smallwins128/pen-plotter/hardware/web/reel/NOTES.md

# Reel notes

Moved on 2026-10-28. The reel method now lives in the `gtm-reel` skill in the copilot repo:
`.claude/skills/gtm-reel/`.

- `SKILL.md`: the steps
- `references/craft.md`: shots, camera and caption rules
- `scripts/render_reel.js`: a generic renderer
- `LEARNINGS.md`: lessons from each reel

This folder keeps the Harbor reel itself as the worked example: `harbor_reel.html`, and
`render_reel.js` hard-wired to it.
