smallwins128/pen-plotter/hardware/labels/labels.pdf

R05 HARBOR · GREY BINS | Print at 100% / actual size. Do not use fit to page.

M3 G01 COUNTERSUNK · FOR 3D PRINTS

CSK | M3 G02 BUTTON · PAN · SOCKET · FLANGE
OTHERS | M4 G03 SHORT LENGTHS

# SMALL

M4 G04 LONG LENGTHS

LARGE | M5 G05 ALL HEADS · ALL LENGTHS

# SCREWS

G06

# RIVETS · RIVNUTS

G07 PLAIN · NYLOC

# NUTS

G08 STANDOFFS

# WASHERS · SPACERS

G09

G10 | G11 | G12

M3 G01 COUNTERSUNK · FOR 3D PRINTS

CSK | M3 G02 BUTTON · PAN · SOCKET · FLANGE
OTHERS | M4 G03 SHORT LENGTHS

# SMALL

M4 G04 LONG LENGTHS

LARGE | M5 G05 ALL HEADS · ALL LENGTHS

# SCREWS

G06

# RIVETS · RIVNUTS

G07 PLAIN · NYLOC

# NUTS

G08 STANDOFFS

# WASHERS · SPACERS

G09

G10 | G11 | G12
Resistor colour code: | M2 red | M3 orange | M4 yellow | M5 green | M6 blue
Black with a shape: nuts, washers, rivets. Bottom edge is a mm scale from the colour block.

## this bar must measure 100 mm after printing

R05 HARBOR · SAMLA BOXES | Print at 100% / actual size. Do not use fit to page. ELECTRONICS
CODE | SIZE | HOME
S01 | 11 L

CONTENTS

# WIRE CARDS

SCAN

# ELECTRONICS

CODE | SIZE | HOME
S02 | 11 L

CONTENTS

# CONNECTORS

SCAN

# ELECTRONICS

CODE | SIZE | HOME
S03 | 11 L

CONTENTS

# HEAT-SHRINK

SCAN

# ELECTRONICS

CODE | SIZE | HOME
S04 | 5 L

CONTENTS

# JUMPERS

SCAN

# ELECTRONICS

CODE | SIZE | HOME
S05 | 5 L

CONTENTS

# WIRE OFFCUTS

SCAN

# ELECTRONICS

CODE | SIZE | HOME
S06 | 5 L

CONTENTS

# DUPONT

SCAN

# HARDWARE

CODE | SIZE | HOME
S07 | 11 L

CONTENTS

# ZIP TIES · ANCHORS

SCAN

# HARDWARE

CODE | SIZE | HOME
S08 | 11 L

CONTENTS

# EDGE GUARDS

SCAN

# PLUMBING

CODE | SIZE | HOME
S09 | 22 L

CONTENTS

# PLUMBING

SCAN

# MECHANICAL

CODE | SIZE | HOME
S10 | 22 L

CONTENTS

# OLD MOTORS

SCAN

R05 HARBOR · SAMLA BOXES | Print at 100% / actual size. Do not use fit to page. WOODWORKING
CODE | SIZE | HOME
S11
CONTENTS | SCAN

# SEWING

CODE | SIZE | HOME
S12
CONTENTS | SCAN

# ART SUPPLIES

CODE | SIZE | HOME
S13
CONTENTS | SCAN

# ELECTRICALS

CODE | SIZE | HOME
S14
CONTENTS | SCAN
CODE | SIZE | HOME
S15
CONTENTS | SCAN
CODE | SIZE | HOME
S16
CONTENTS | SCAN
