smallwins128/pen-plotter/hardware/labels/labels_plus7.pdf

M3

# CSK

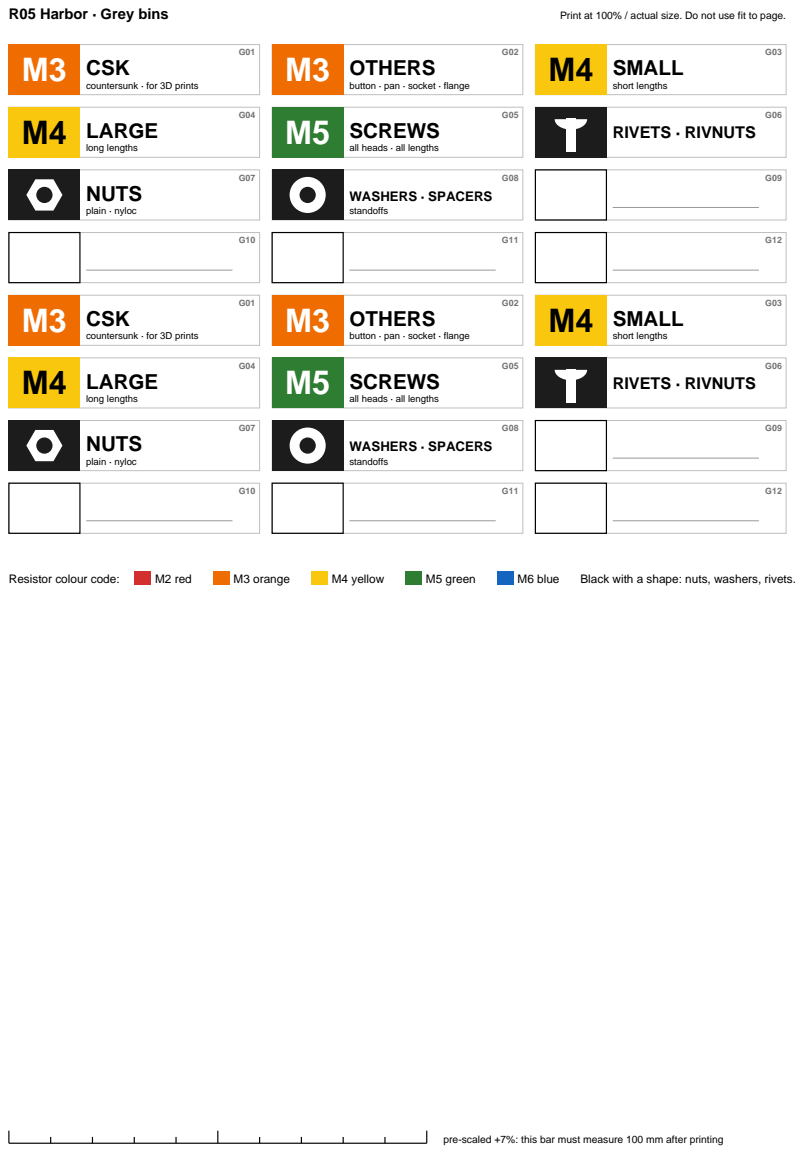
[picture p1: page 1]
R05 Harbor · Grey bins; Print at 100% / actual size. Do not use fit to page.; countersunk · for 3D prints; OTHERS; SMALL; short lengths; LARGE; long lengths; SCREWS; RIVETS · RIVNUTS; NUTS; plain · nyloc; WASHERS · SPACERS; standoffs; CSK; Resistor colour code:; M2 red; M3 orange; M4 yellow; M5 green; M6 blue; Black with a shape: nuts, washers, rivets.

button · pan · socket · flange

all heads · all lengths

countersunk · for 3D prints

pre-scaled +7%: this bar must measure 100 mm after printing

R05 Harbor · SAMLA boxes | Print at 100% / actual size. Do not use fit to page.
S01 | ELECTRONICS

# WIRE CARDS

11 L

HOME RB-1

S02 | ELECTRONICS

# CONNECTORS

11 L

HOME RB-1

S03 | ELECTRONICS

# HEAT-SHRINK

11 L

HOME RB-2

S04 | ELECTRONICS

# JUMPERS

5 L

HOME A3-C

S05 | ELECTRONICS

# WIRE OFFCUTS

5 L

HOME A3-C

S06 | ELECTRONICS

# DUPONT

5 L

HOME A3-C

S07 | HARDWARE

# ZIP TIES · ANCHORS

11 L

# HOME A3-UL

S08 | HARDWARE

# EDGE GUARDS

11 L

# HOME A3-UL

S09 | PLUMBING

# PLUMBING

22 L

# HOME A3-UR

S10 | MECHANICAL

# OLD MOTORS

22 L

# HOME A3-LL

R05 Harbor · SAMLA boxes | Print at 100% / actual size. Do not use fit to page.
S11 | WOODWORKING

HOME

S12 | SEWING

HOME

S13 | ART SUPPLIES

HOME

S14 | ELECTRICALS

HOME
S15

HOME

S16

HOME

R05 Harbor · Cupboard and rack spots | Print at 100% / actual size. Do not use fit to page.

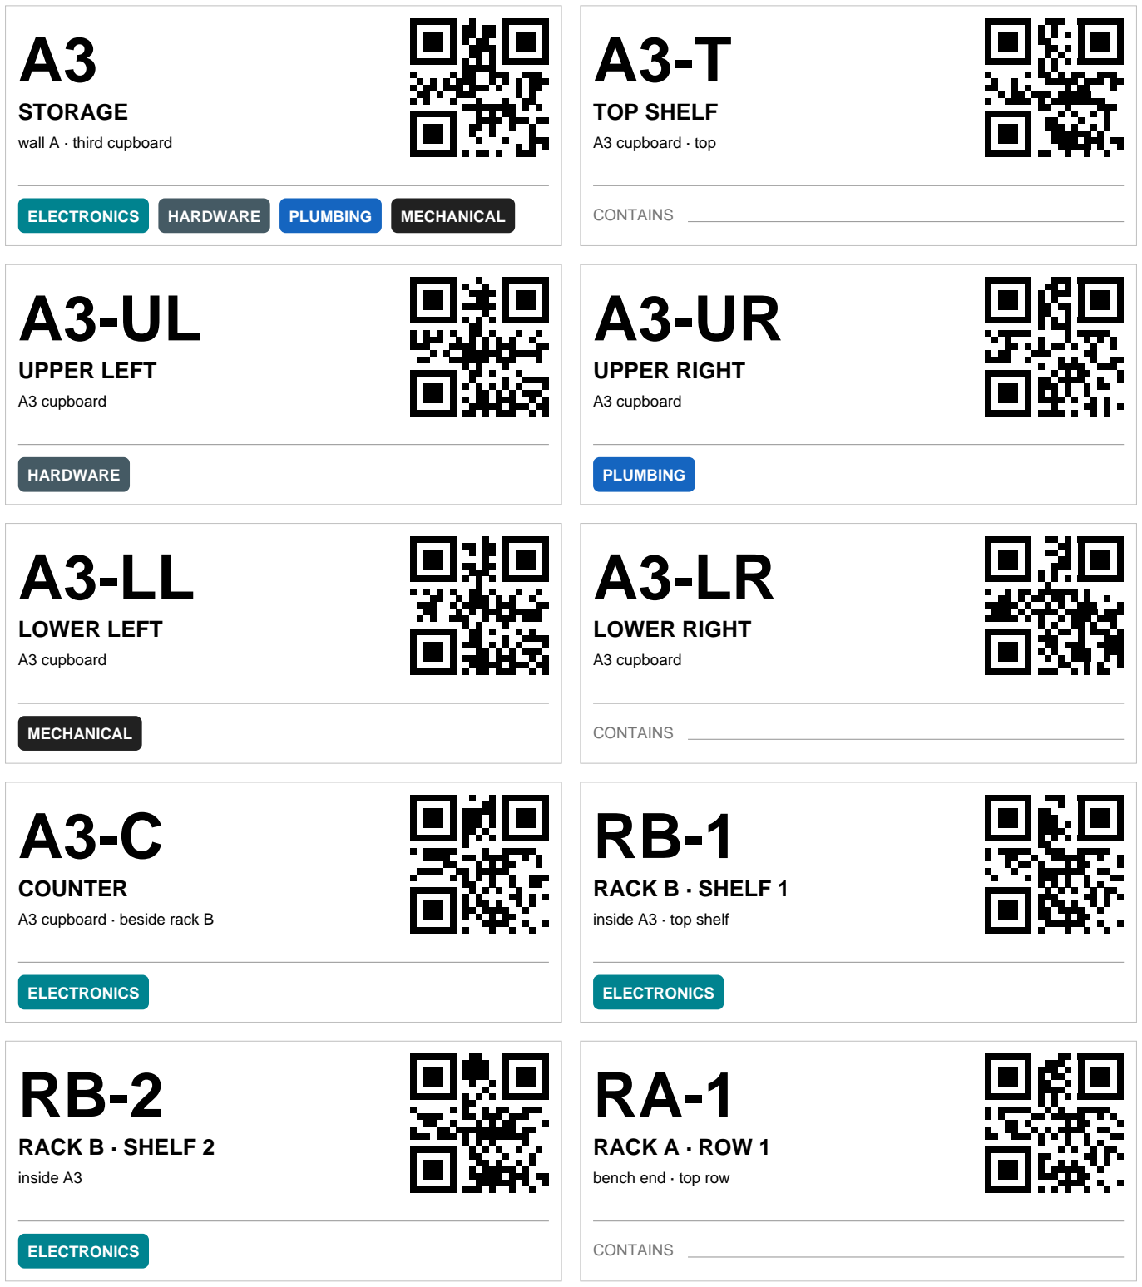
[picture p2: figure]
STORAGE; wall A · third cupboard; ELECTRONICS; HARDWARE; PLUMBING; MECHANICAL; TOP SHELF; A3 cupboard · top; CONTAINS; UPPER LEFT; A3 cupboard; UPPER RIGHT; LOWER LEFT; LOWER RIGHT; COUNTER; A3 cupboard · beside rack B; RACK B · SHELF 1; inside A3 · top shelf; RACK B · SHELF 2; inside A3; RACK A · ROW 1; bench end · top row

RA-2

## RACK A · ROW 2

bench end

CONTAINS

RA-3

## RACK A · ROW 3

bench end · bottom row

CONTAINS
