smallwins128/pen-plotter/hardware/out/din_mounts/preview.png

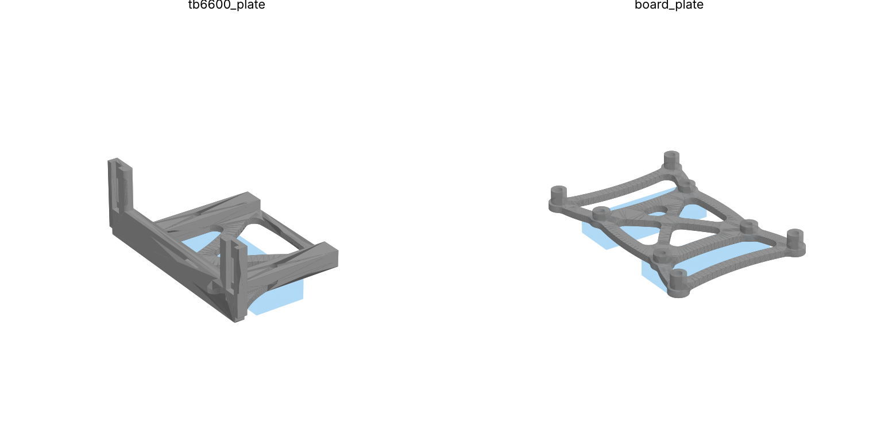
hardware/out/din_mounts/preview.png
