smallwins128/pen-plotter/hardware/out/layout/control_layout.png

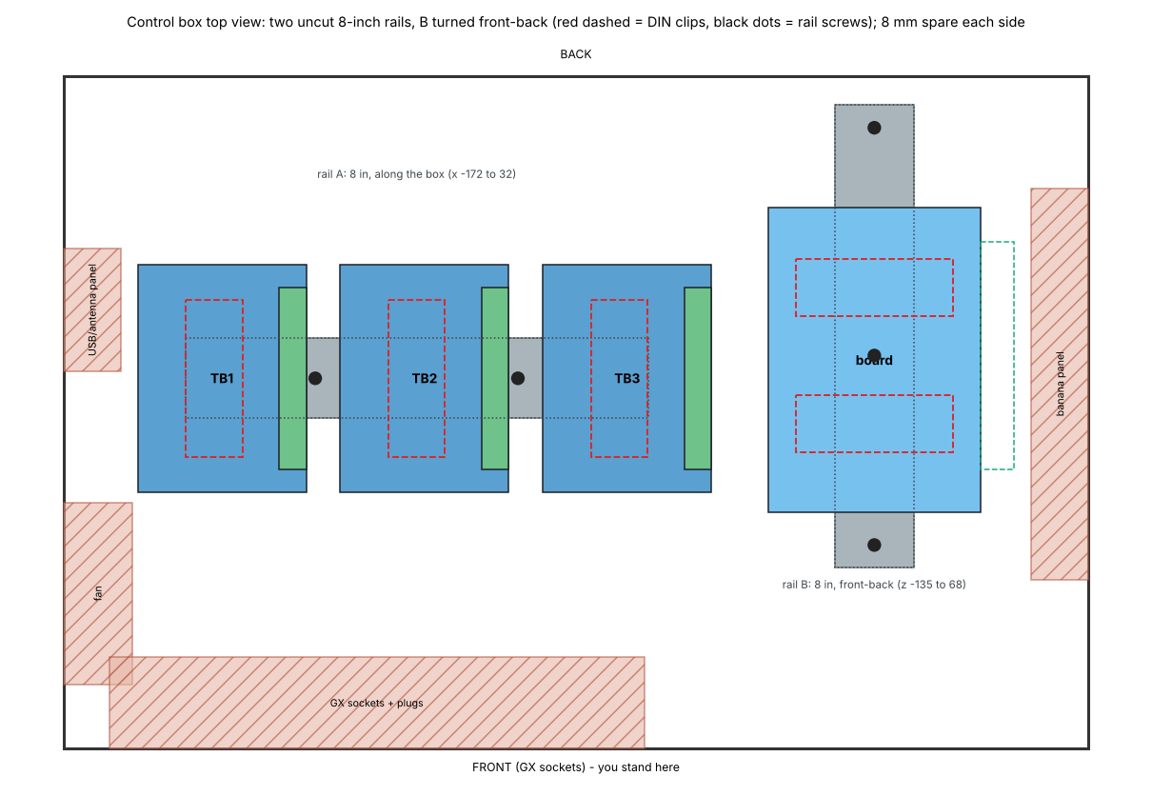
hardware/out/layout/control_layout.png
