smallwins128/pen-plotter/hardware/cutfiles/2026-10-15 Acrylic windows v1/ACRYLIC_WINDOWS.dxf

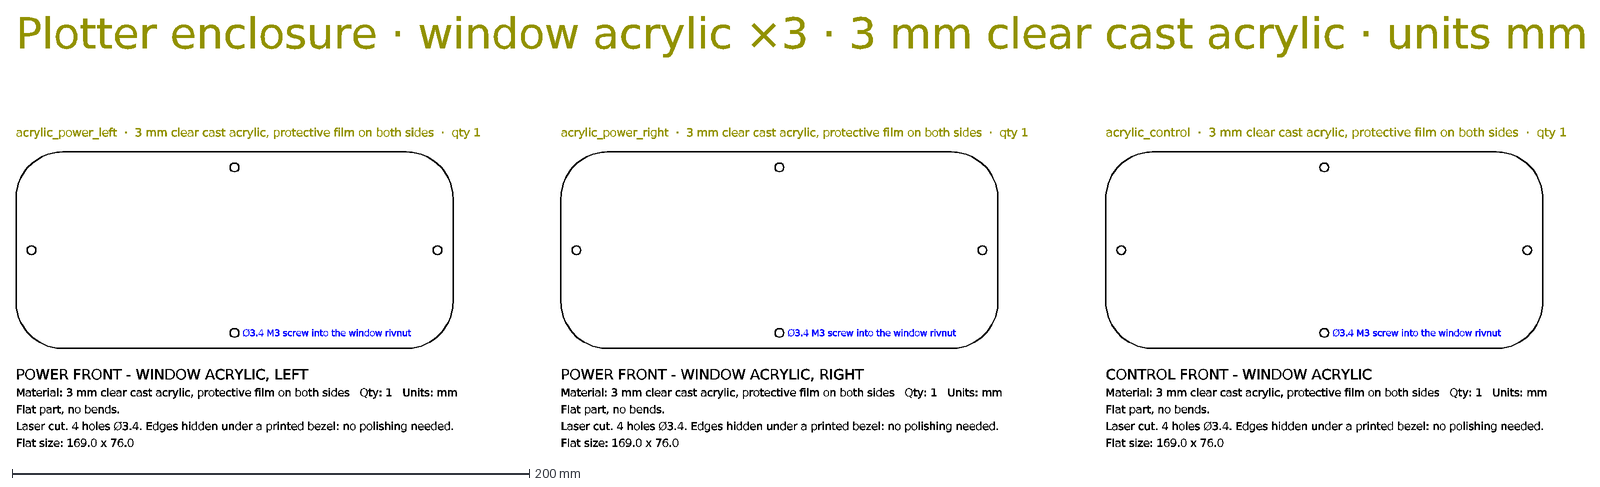
[picture p15: CAD file, 2026-10-15]
hardware/cutfiles/2026-10-15 Acrylic windows v1/ACRYLIC_WINDOWS.dxf
Ø3.4 M3 screw into the window rivnut
POWER FRONT - WINDOW ACRYLIC, LEFT
Material: 3 mm clear cast acrylic, protective film on both sides Qty: 1 Units: mm
Flat part, no bends.
Laser cut. 4 holes Ø3.4. Edges hidden under a printed bezel: no polishing needed.
Flat size: 169.0 x 76.0
acrylic_power_left · 3 mm clear cast acrylic, protective film on both sides · qty 1
POWER FRONT - WINDOW ACRYLIC, RIGHT
acrylic_power_right · 3 mm clear cast acrylic, protective film on both sides · qty 1
CONTROL FRONT - WINDOW ACRYLIC
acrylic_control · 3 mm clear cast acrylic, protective film on both sides · qty 1
Plotter enclosure · window acrylic ×3 · 3 mm clear cast acrylic · units mm
