smallwins128/pen-plotter/hardware/cutfiles/2026-10-16 v6/DXF 2004/control_lid.dxf

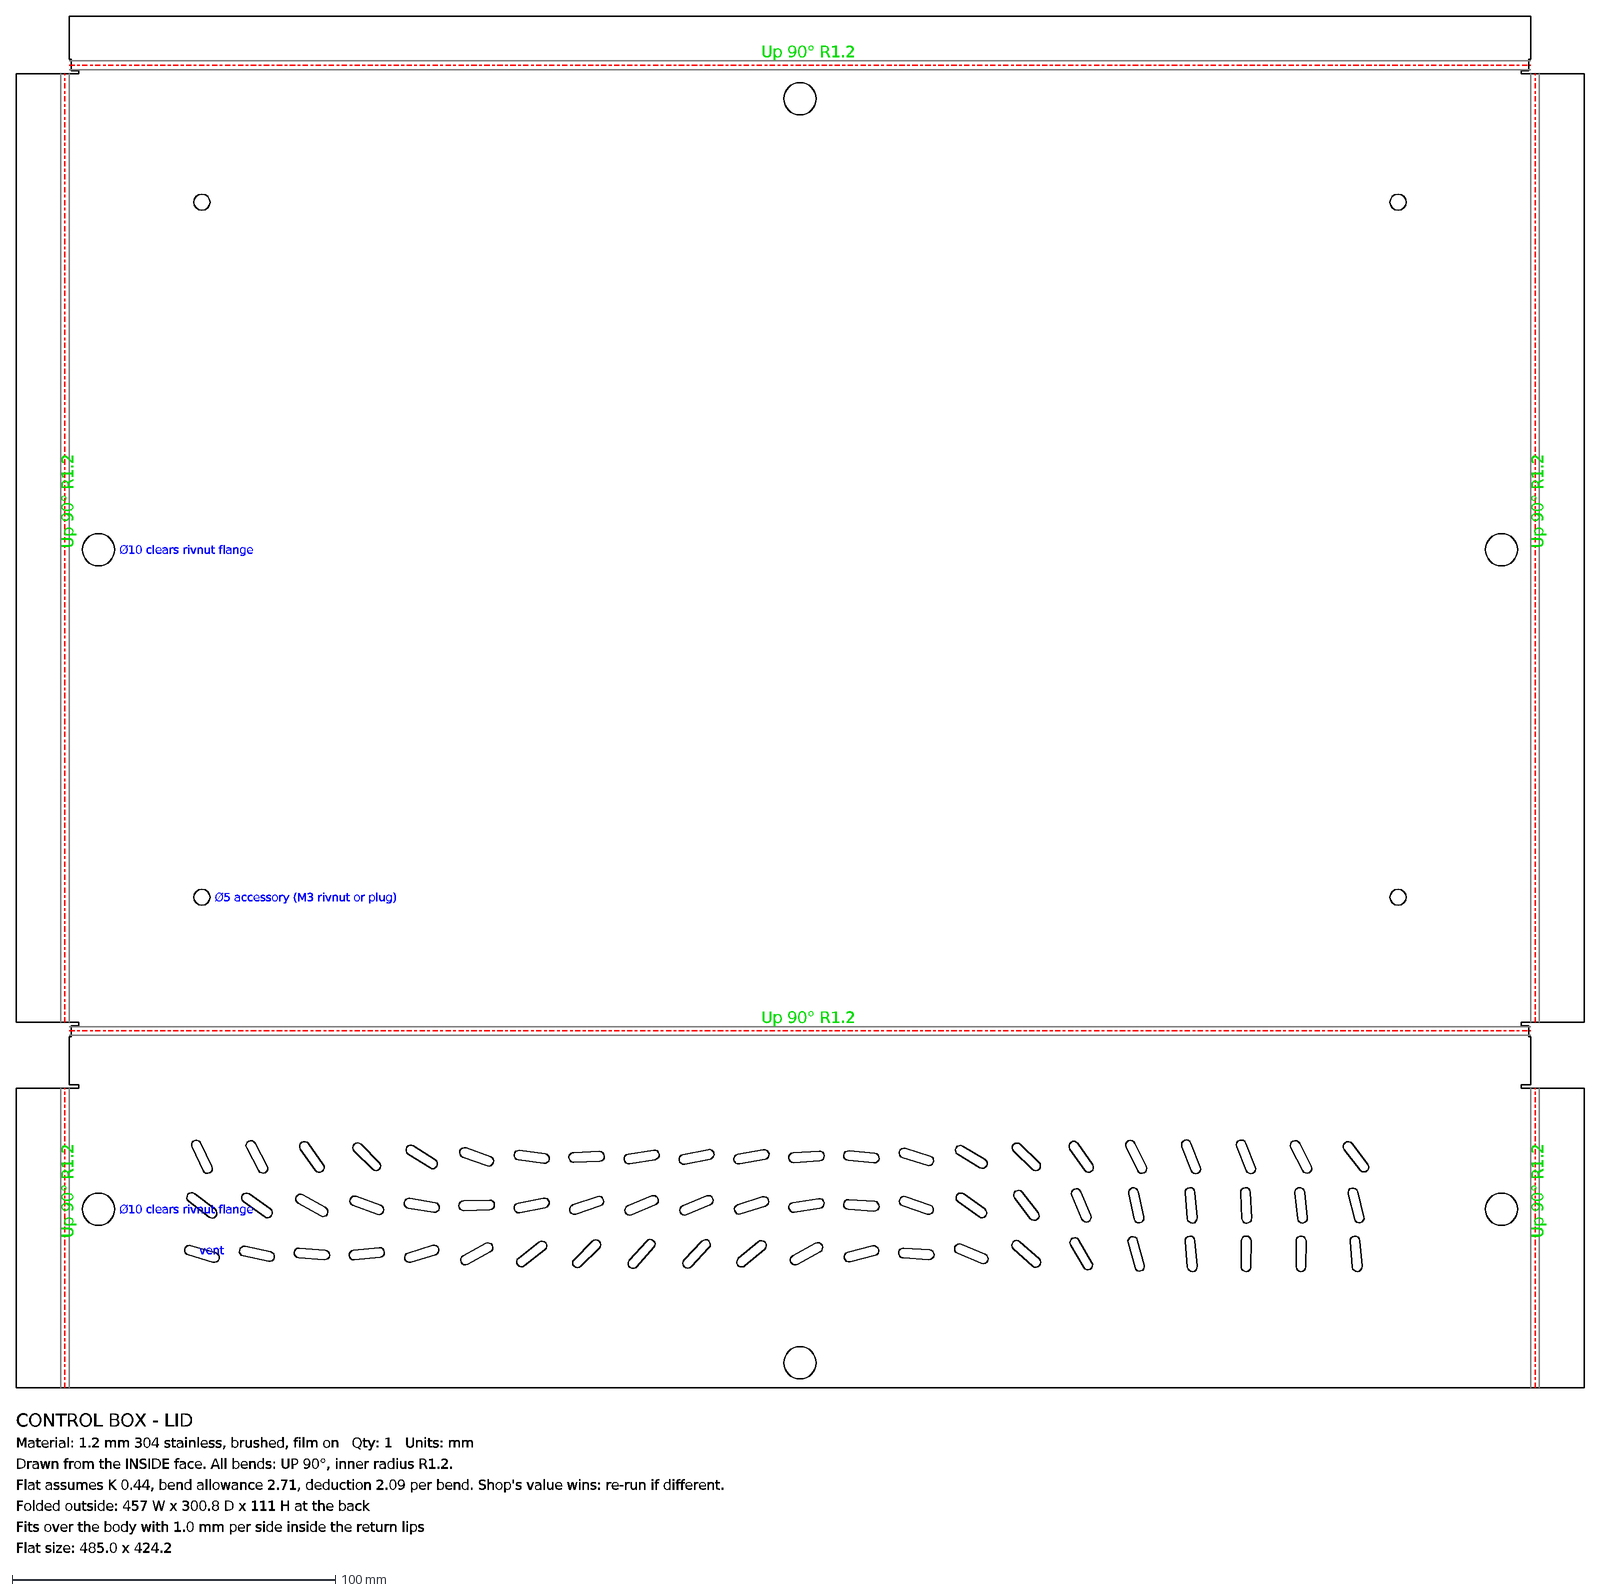
[picture p16: CAD file, 2026-10-29]
hardware/cutfiles/2026-10-16 v6/DXF 2004/control_lid.dxf
Up 90° R1.2
Ø10 clears rivnut flange
Ø5 accessory (M3 rivnut or plug)
vent
CONTROL BOX - LID
Material: 1.2 mm 304 stainless, brushed, film on Qty: 1 Units: mm
Drawn from the INSIDE face. All bends: UP 90°, inner radius R1.2.
Flat assumes K 0.44, bend allowance 2.71, deduction 2.09 per bend. Shop's value wins: re-run if different.
Folded outside: 457 W x 300.8 D x 111 H at the back
Fits over the body with 1.0 mm per side inside the return lips
Flat size: 485.0 x 424.2
