smallwins128/pen-plotter/hardware/out/bend_jig/bend_sleeve_d24.stl

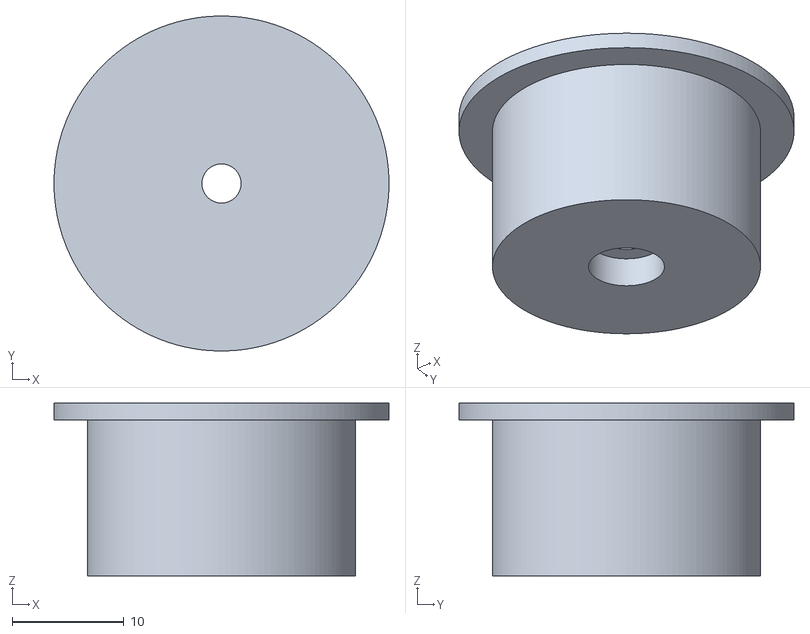
[picture p17: CAD file, 2026-10-29]
hardware/out/bend_jig/bend_sleeve_d24.stl
30.0 x 30.0 x 15.5
