smallwins128/pen-plotter/hardware/out/din_grip/din_grip_anchor_c0.3.stl

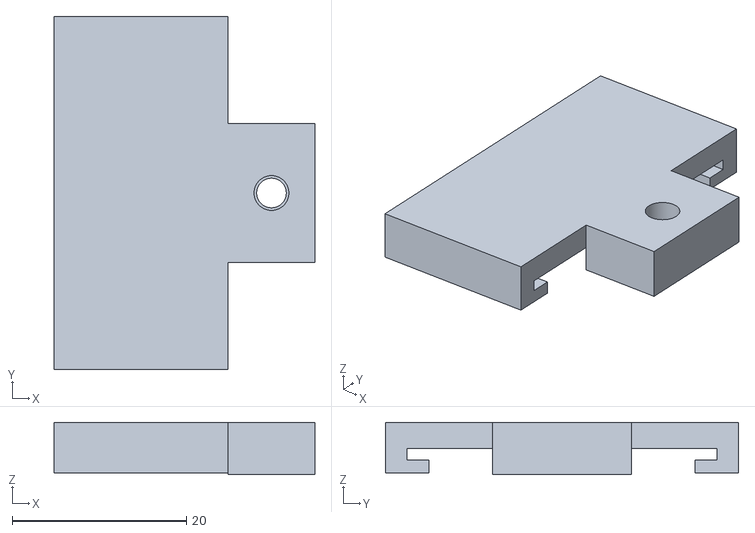
[picture p18: CAD file, 2026-10-29]
hardware/out/din_grip/din_grip_anchor_c0.3.stl
30.0 x 40.6 x 6.00
