smallwins128/pen-plotter/hardware/out/din_mounts/board_plate.stl

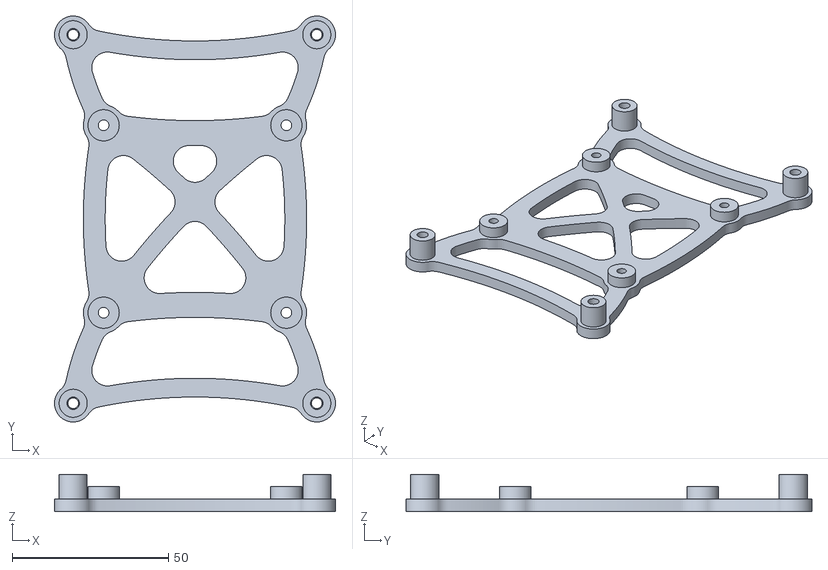
[picture p19: CAD file, 2026-10-29]
hardware/out/din_mounts/board_plate.stl
90.0 x 130.0 x 12.0
