smallwins128/pen-plotter/hardware/cutfiles/2026-10-14 v5/control_base_plate.dxf

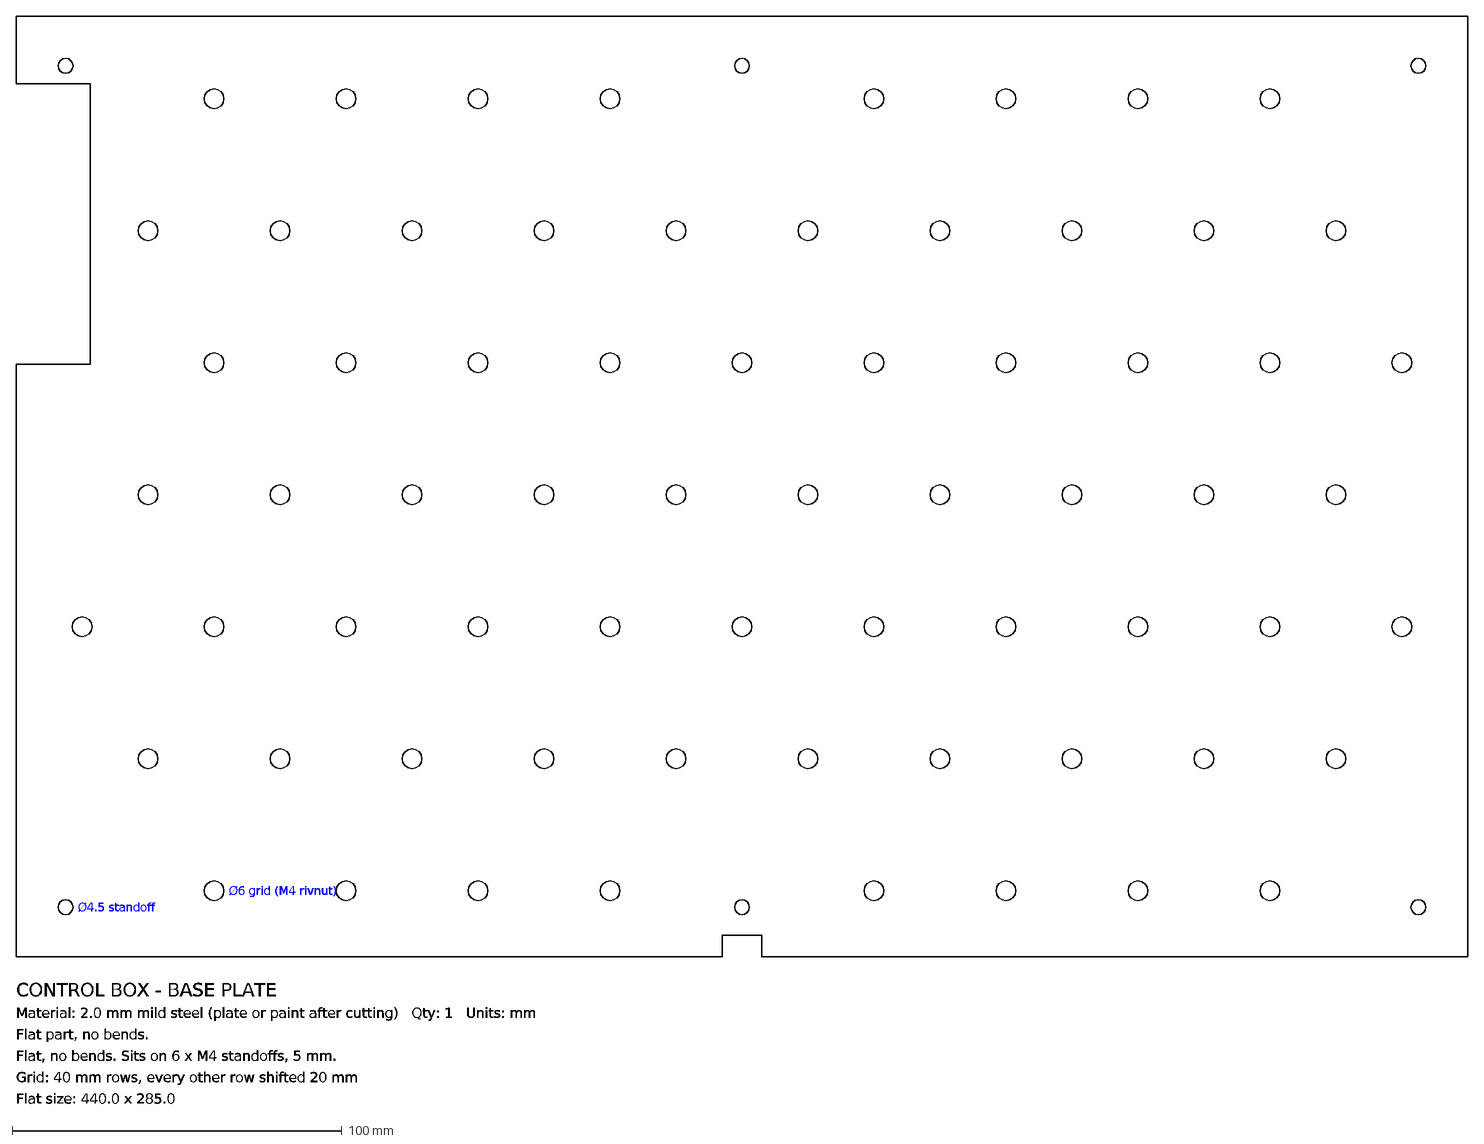
[picture p20: CAD file, 2026-10-14]
hardware/cutfiles/2026-10-14 v5/control_base_plate.dxf
Ø4.5 standoff
Ø6 grid (M4 rivnut)
CONTROL BOX - BASE PLATE
Material: 2.0 mm mild steel (plate or paint after cutting) Qty: 1 Units: mm
Flat part, no bends.
Flat, no bends. Sits on 6 x M4 standoffs, 5 mm.
Grid: 40 mm rows, every other row shifted 20 mm
Flat size: 440.0 x 285.0
