smallwins128/pen-plotter/hardware/out/din_grip/din_grip_coupon_c0.3.stl

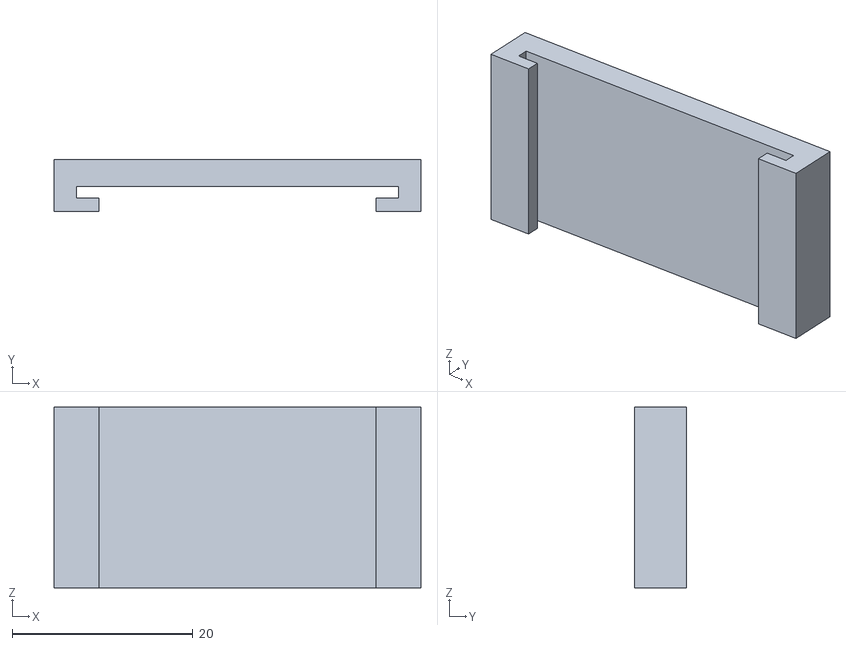
[picture p23: CAD file, 2026-10-29]
hardware/out/din_grip/din_grip_coupon_c0.3.stl
40.6 x 5.80 x 20.0
