smallwins128/pen-plotter/hardware/out/din_mounts/tb6600_plate.stl

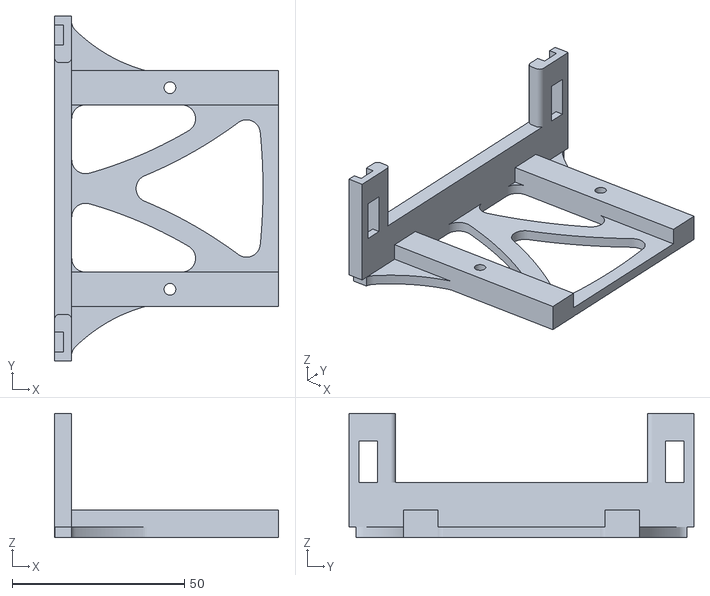
[picture p24: CAD file, 2026-10-29]
hardware/out/din_mounts/tb6600_plate.stl
65.0 x 100.0 x 36.0
