smallwins128/pen-plotter/hardware/cutfiles/2026-10-14 v5/power_lid.dxf

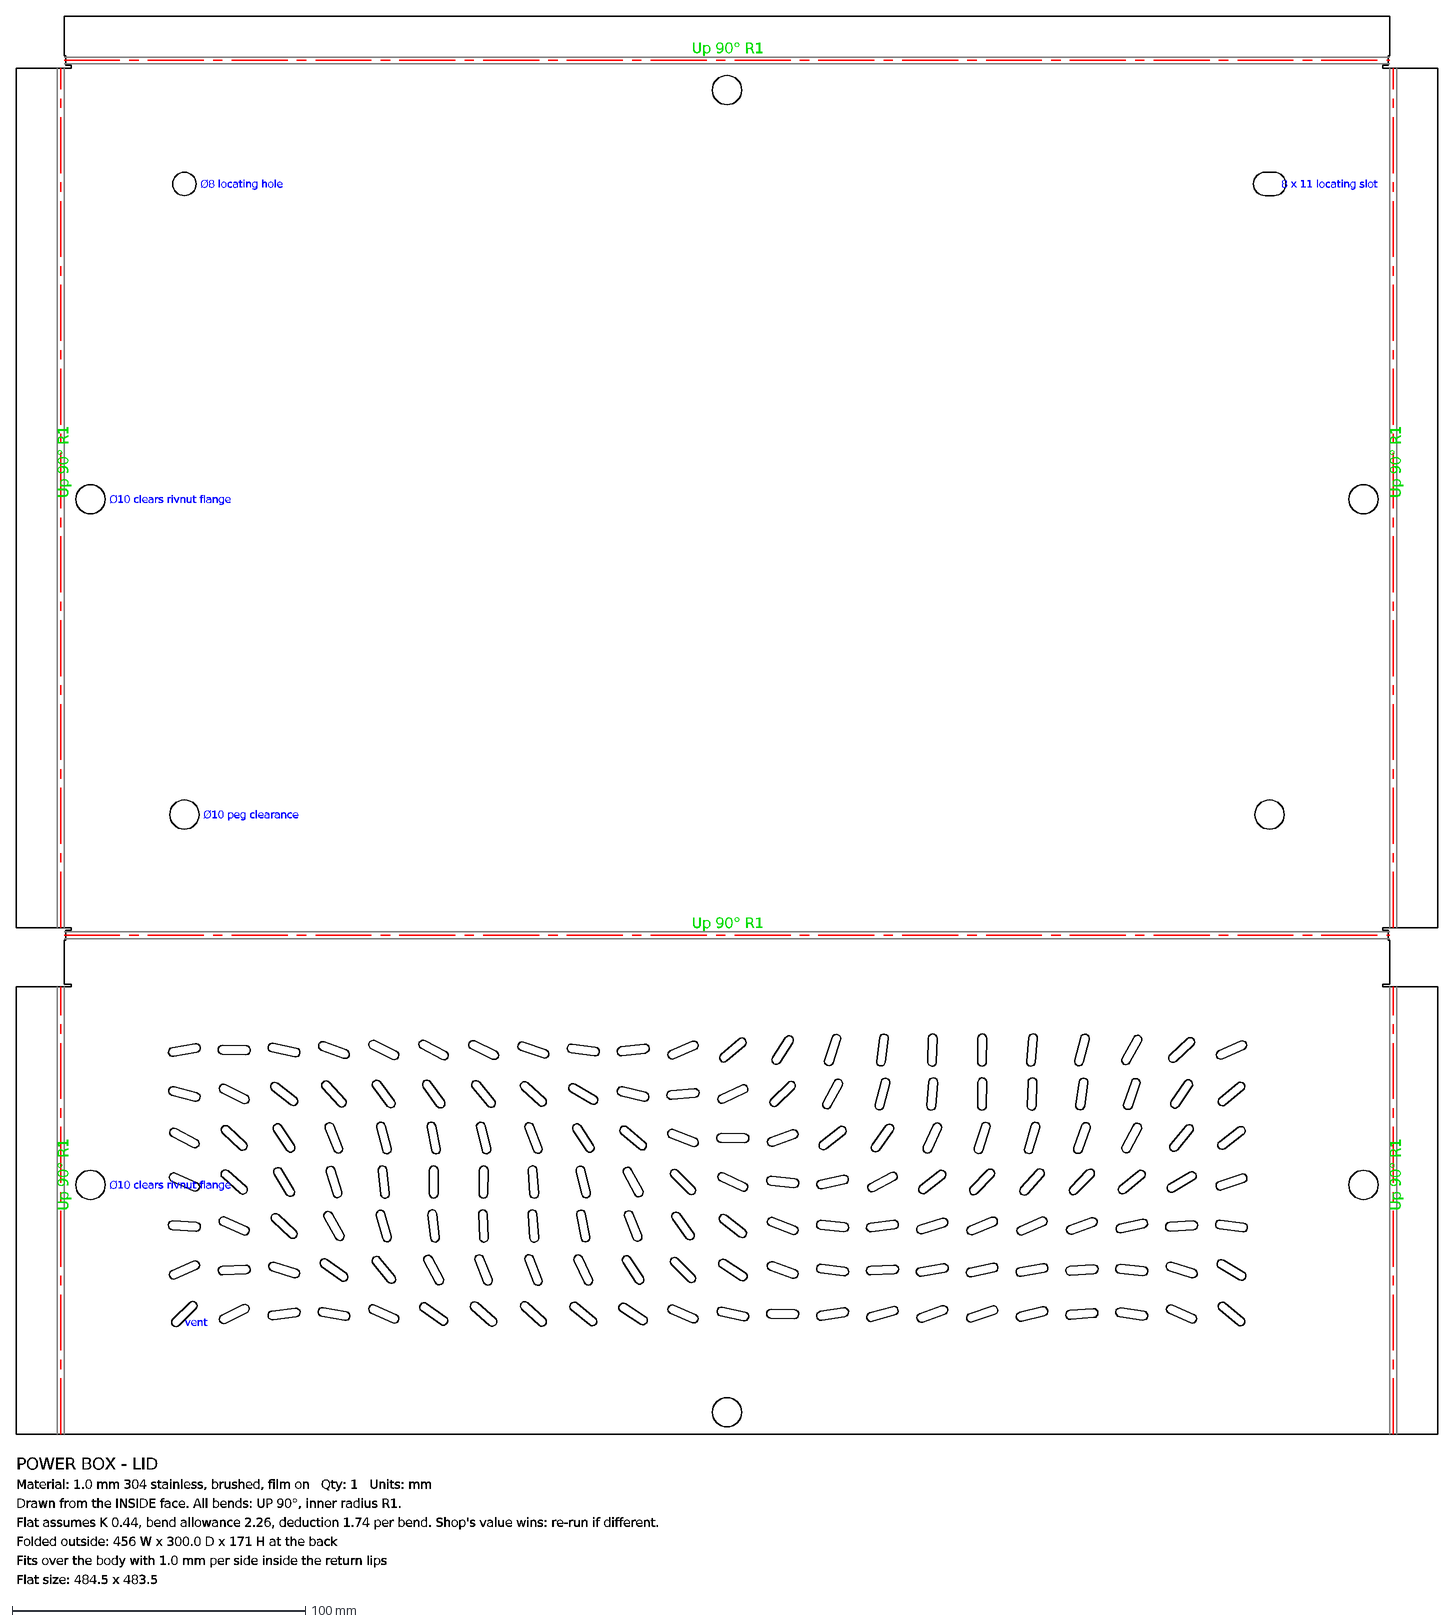
[picture p32: CAD file, 2026-10-14]
hardware/cutfiles/2026-10-14 v5/power_lid.dxf
Up 90° R1
Ø10 clears rivnut flange
Ø8 locating hole
8 x 11 locating slot
Ø10 peg clearance
vent
POWER BOX - LID
Material: 1.0 mm 304 stainless, brushed, film on Qty: 1 Units: mm
Drawn from the INSIDE face. All bends: UP 90°, inner radius R1.
Flat assumes K 0.44, bend allowance 2.26, deduction 1.74 per bend. Shop's value wins: re-run if different.
Folded outside: 456 W x 300.0 D x 171 H at the back
Fits over the body with 1.0 mm per side inside the return lips
Flat size: 484.5 x 483.5
