smallwins128/pen-plotter/hardware/cutfiles/2026-10-14 v5/acrylic_power_left.dxf

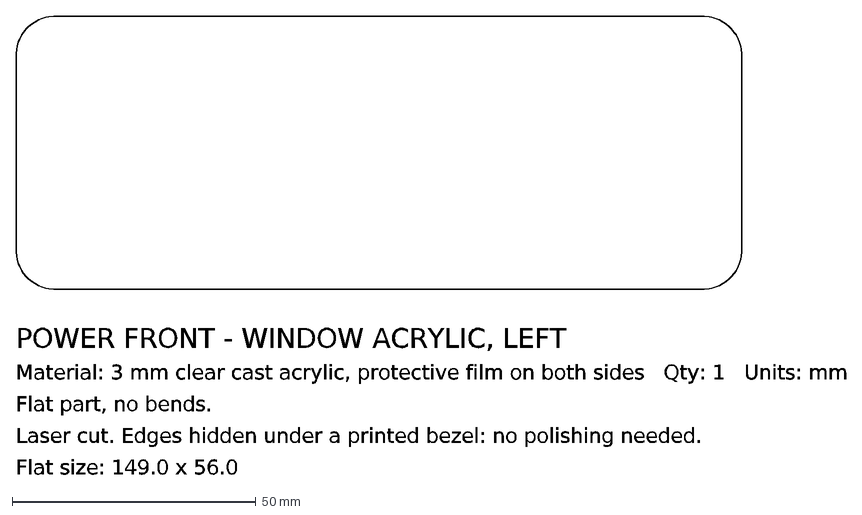
[picture p35: CAD file, 2026-10-14]
hardware/cutfiles/2026-10-14 v5/acrylic_power_left.dxf
POWER FRONT - WINDOW ACRYLIC, LEFT
Material: 3 mm clear cast acrylic, protective film on both sides Qty: 1 Units: mm
Flat part, no bends.
Laser cut. Edges hidden under a printed bezel: no polishing needed.
Flat size: 149.0 x 56.0
