smallwins128/pen-plotter/(list of files, cad)

Other CAD files:
hardware/cutfiles/2026-10-14 v5/ALL_MS.dxf
hardware/cutfiles/2026-10-14 v5/DXF 2004/ALL_ACRYLIC.dxf
hardware/cutfiles/2026-10-16 v6/power_body.dxf
hardware/cutfiles/2026-10-16 v6/DXF 2004/control_body.dxf
hardware/cutfiles/2026-10-14 v5/ALL_PARTS.dxf
hardware/cutfiles/2026-10-14 v5/power_base_plate.dxf
hardware/cutfiles/2026-10-14 v5/ALL_SS304.dxf
hardware/cutfiles/2026-10-14 v5/DXF 2004/control_body.dxf
hardware/cutfiles/2026-10-14 v5/ALL_ACRYLIC.dxf
hardware/cutfiles/2026-10-14 v5/ALL_STEEL_PARTS.dxf
hardware/cutfiles/2026-10-14 v5/DXF 2004/ALL_PARTS.dxf
hardware/cutfiles/2026-10-14 v5/ALL_ACRYLIC_PARTS.dxf
hardware/cutfiles/2026-10-14 v5/DXF 2004/control_base_plate.dxf
hardware/cutfiles/2026-10-14 v5/DXF 2004/ALL_MS.dxf
hardware/cutfiles/2026-10-14 v5/DXF 2004/power_body.dxf
hardware/cutfiles/2026-10-14 v5/power_body.dxf
hardware/cutfiles/2026-10-14 v5/DXF 2004/ALL_SS304.dxf
hardware/cutfiles/2026-10-14 v5/control_body.dxf
hardware/cutfiles/2026-10-11 v1/control_body.dxf
hardware/cutfiles/2026-10-11 v1/control_lid.dxf
hardware/cutfiles/2026-10-11 v1/power_body.dxf
hardware/cutfiles/2026-10-11 v1/power_lid.dxf
hardware/cutfiles/2026-10-11 v2/control_base_plate.dxf
hardware/cutfiles/2026-10-11 v2/control_body.dxf
hardware/cutfiles/2026-10-11 v2/power_base_plate.dxf
hardware/cutfiles/2026-10-11 v3/control_base_plate.dxf
hardware/cutfiles/2026-10-11 v3/power_base_plate.dxf
hardware/cutfiles/2026-10-11 v3/power_body.dxf
hardware/cutfiles/2026-10-11 v4/control_body.dxf
hardware/cutfiles/2026-10-11 v4/control_lid.dxf
hardware/cutfiles/2026-10-11 v4/power_body.dxf
hardware/cutfiles/2026-10-11 v4/power_lid.dxf
hardware/cutfiles/2026-10-12 v4/acrylic_control.dxf
hardware/cutfiles/2026-10-12 v4/acrylic_power_left.dxf
hardware/cutfiles/2026-10-12 v4/acrylic_power_right.dxf
hardware/cutfiles/2026-10-12 v4/control_base_plate.dxf
hardware/cutfiles/2026-10-12 v4/control_body.dxf
hardware/cutfiles/2026-10-12 v4/power_body.dxf
hardware/out/din_mounts/board_plate.dxf
hardware/out/din_mounts/tb6600_plate.dxf
