smallwins128/pen-plotter/hardware/cutfiles/2026-10-11 v4/2026-10-11 Plotter enclosure cut pack v4.pdf

# Plotter enclosures · cut & bend pack

Two stacked electronics boxes (control on top, power below), each a folded body + a folded lid, plus two flat base plates. Prepared by Allwin Tom · 2026-10-11 · v4

# | File | Part | Material | Qty | Flat (mm) | Bends | Folded outside (mm)

1 | control_body.dxf | CONTROL BOX · BODY | 1.0 mm 304 stainless, brushed, film on | 1 | 699.0 × 434.8 | 11 | 452 W × 297 D × 111 H
2 | control_lid.dxf | CONTROL BOX · LID | 1.0 mm 304 stainless, brushed, film on | 1 | 484.5 × 423.5 | 6 | 456 W × 300.0 D × 111 H (back)
3 | control_base_plate.dxf | CONTROL BOX · BASE PLATE | 2.0 mm aluminium 5052 (or 1.5 mm 304) | 1 | 440.0 × 285.0 | 0 | flat, 440 × 285, notched
4 | power_body.dxf | POWER BOX · BODY | 1.0 mm 304 stainless, brushed, film on | 1 | 819.0 × 494.8 | 11 | 452 W × 297 D × 171 H
5 | power_lid.dxf | POWER BOX · LID | 1.0 mm 304 stainless, brushed, film on | 1 | 484.5 × 483.5 | 6 | 456 W × 300.0 D × 171 H (back)
6 | power_base_plate.dxf | POWER BOX · BASE PLATE | 2.0 mm aluminium 5052 (or 1.5 mm 304) | 1 | 440.0 × 285.0 | 0 | flat, 440 × 285, notched

Bending

Every flat is drawn from the inside face. Every bend is UP 90°, inner radius R1.
Flats assume K 0.44, bend allowance 2.262 mm, bend deduction 1.738 mm per 90° bend (1 mm 304, R = t). If your bend deduction for 1 mm 304 at R1 differs, tell us the number: we re-issue the flats so every hole lands where it should.
Bend order: small lips first (top lips, back lips, corner tabs, base back lip), then the side walls, then the front wall last. Lid: return lips first, then the top-to-back bend.
Corner reliefs and end-of-flange reliefs are already cut into the outline.
Deliberate gaps, please keep: flange ends stop 2.5 mm short of neighbouring flanges; side-wall front edges and corner tabs stop 0.5 mm short of the front wall (the rivets close it); the lid is 1.0 mm per side larger than the body.

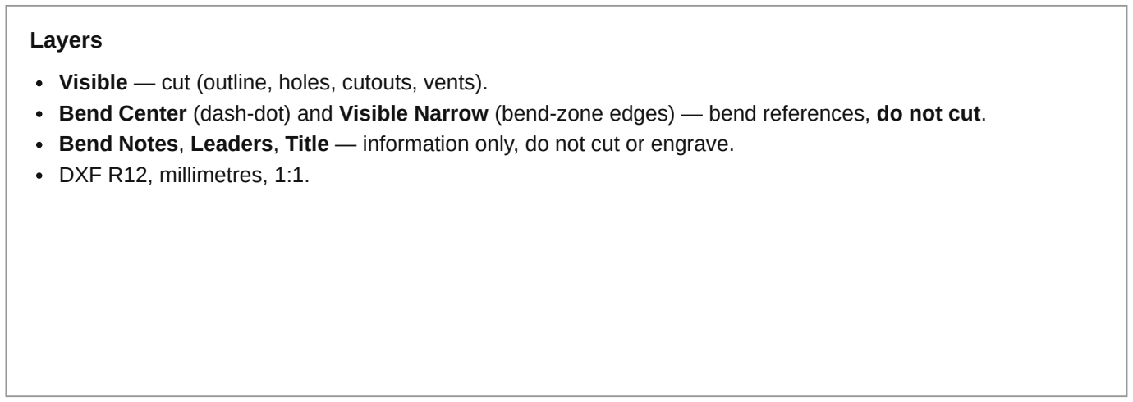
[picture p148: figure]
Layers; DXF R12, millimetres, 1:1.

Visible — cut (outline, holes, cutouts, vents).
Bend Center (dash-dot) and Visible Narrow (bend-zone edges) — bend references, do not cut. Bend Notes, Leaders, Title — information only, do not cut or engrave.

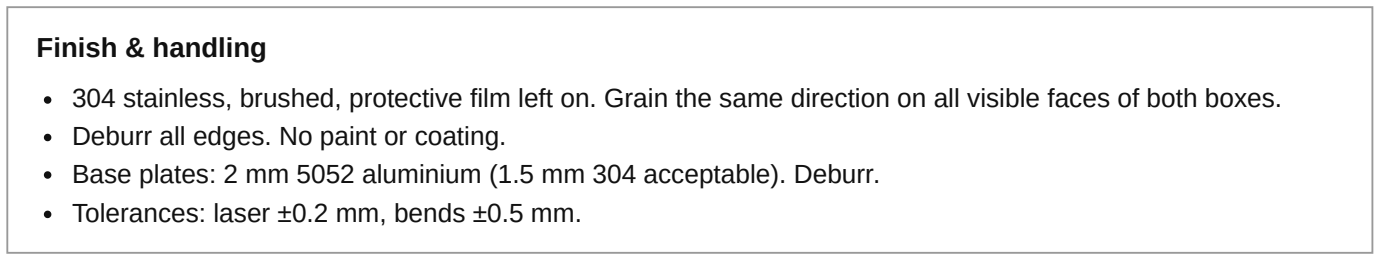
[picture p149: figure]
Finish & handling; Deburr all edges. No paint or coating.

304 stainless, brushed, protective film left on. Grain the same direction on all visible faces of both boxes.

Base plates: 2 mm 5052 aluminium (1.5 mm 304 acceptable). Deburr.
Tolerances: laser ±0.2 mm, bends ±0.5 mm.

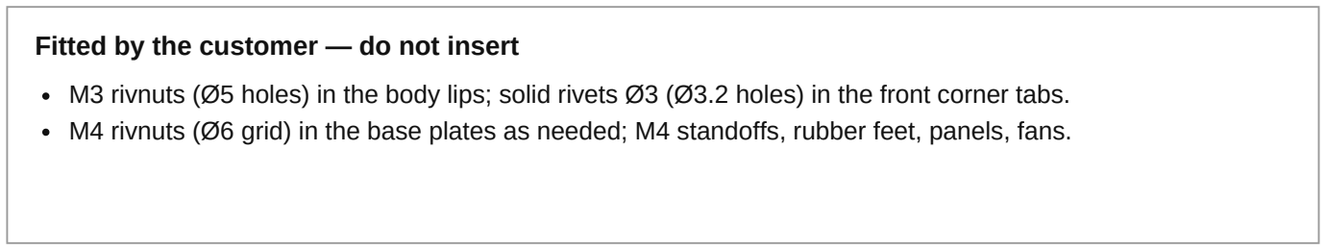
[picture p150: figure]
Fitted by the customer — do not insert

M3 rivnuts (Ø5 holes) in the body lips; solid rivets Ø3 (Ø3.2 holes) in the front corner tabs. M4 rivnuts (Ø6 grid) in the base plates as needed; M4 standoffs, rubber feet, panels, fans.

Checks: 723 design checks passed before these files were written — holes clear of bends (≥ 5 mm), webs ≥ 1.5 mm, folded parts free of clashes, folded flanges at least 2 mm apart wherever they are not meant to touch, whole assembly (fans, panels, rivnuts, base plate, standoffs) clear by 2 mm, lid clear of the body, every lid hole over its rivnut, base-plate standoffs over the floor's, panel cutouts and screw patterns matched to the printed panels. The files were then read back and re-folded from their own bend lines:

refold body width: 452.00 (design 452.00)
refold left wall height: 111.00 (design 111.00)
refold right wall height: 111.00 (design 111.00) refold body depth (base): 297.00 (design 297.00) refold front wall height: 111.00 (design 111.00) refold lid width: 456.00 (design 456.00)
refold lid depth: 300.00 (design 300.00)
refold body width: 452.00 (design 452.00) refold left wall height: 171.00 (design 171.00) refold right wall height: 171.00 (design 171.00)

refold body depth (base): 297.00 (design 297.00) refold front wall height: 171.00 (design 171.00) refold lid width: 456.00 (design 456.00)
refold lid depth: 300.00 (design 300.00)

### 1 · CONTROL BOX · BODY

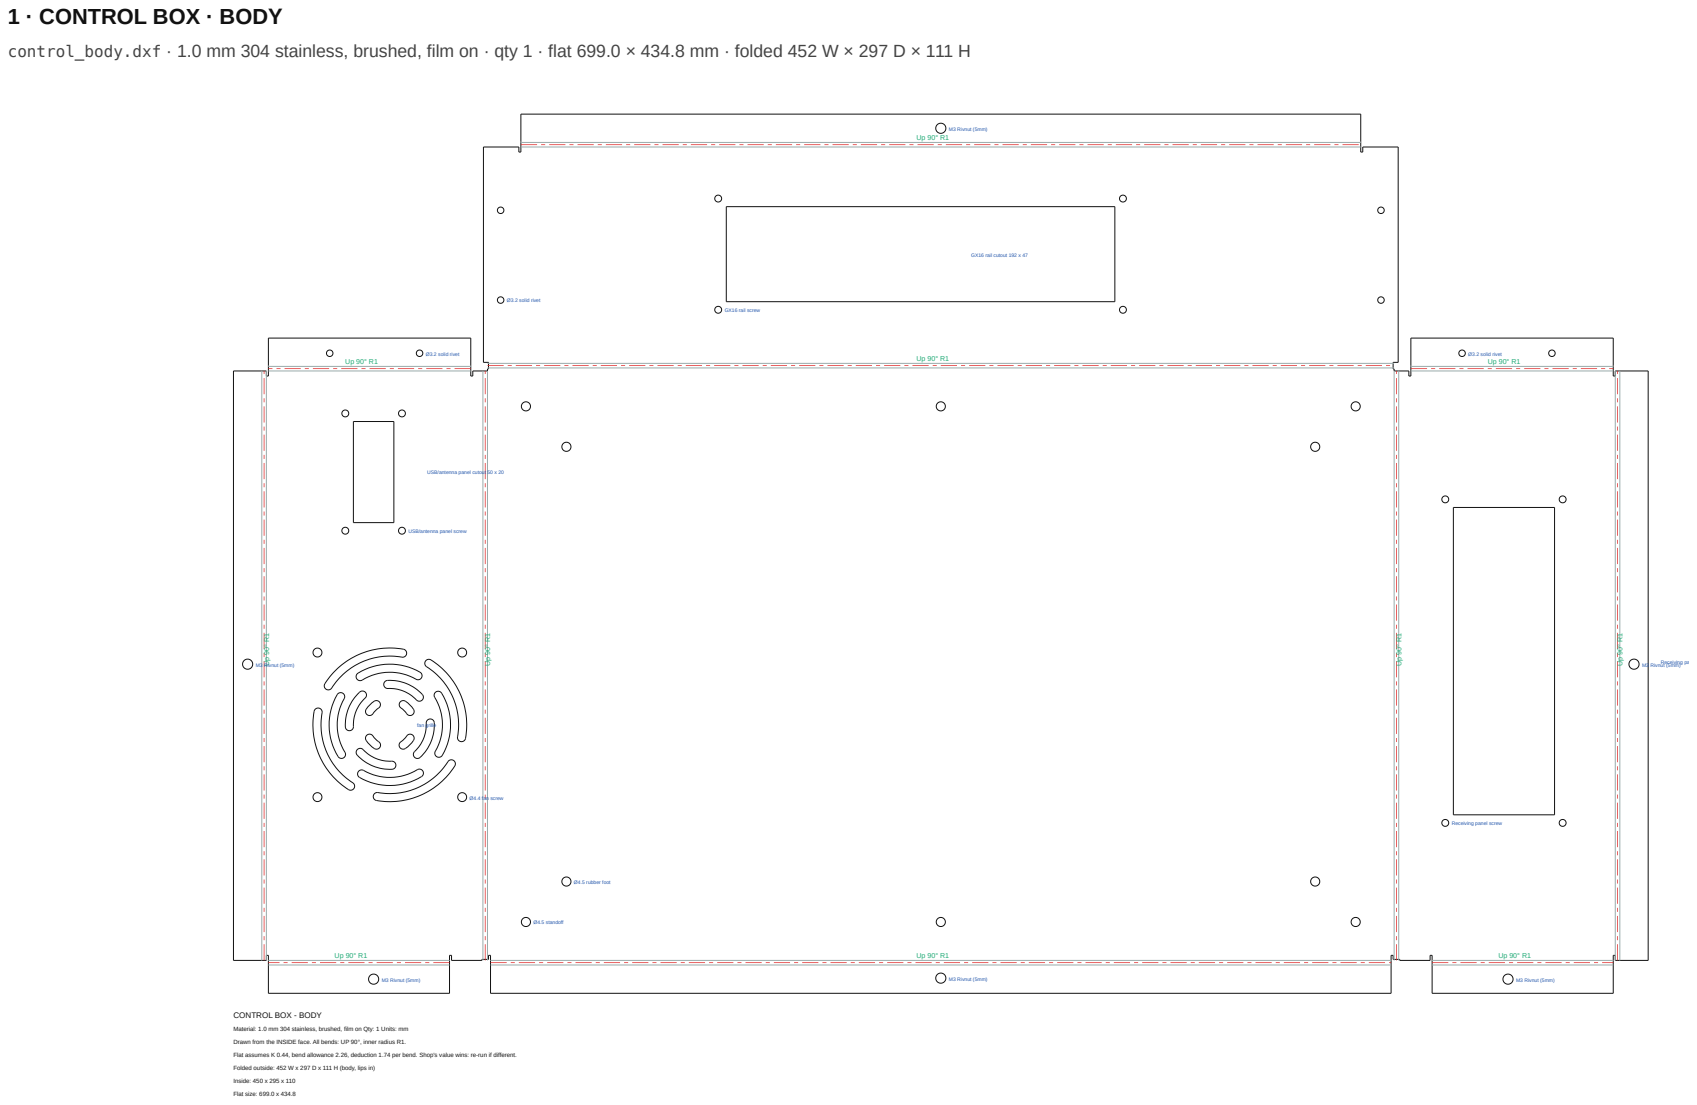
[picture p151: page 3]
Ø3.2 solid rivet; M3 Rivnut (5mm); Ø4.5 standoff; Ø4.5 rubber foot; GX16 rail cutout 192 x 47; GX16 rail screw; fan grille; Ø4.4 fan screw; Receiving pa; Inside: 450 x 295 x 110; Flat size: 699.0 x 434.8

control_body.dxf · 1.0 mm 304 stainless, brushed, film on · qty 1 · flat 699.0 × 434.8 mm · folded 452 W × 297 D × 111 H

USB/antenna panel cutout 50 x 20

USB/antenna panel screw

Receiving panel screw

CONTROL BOX - BODY

Material: 1.0 mm 304 stainless, brushed, film on Qty: 1 Units: mm

Drawn from the INSIDE face. All bends: UP 90°, inner radius R1.

Flat assumes K 0.44, bend allowance 2.26, deduction 1.74 per bend. Shop's value wins: re-run if different.

Folded outside: 452 W x 297 D x 111 H (body, lips in)

### 2 · CONTROL BOX · LID

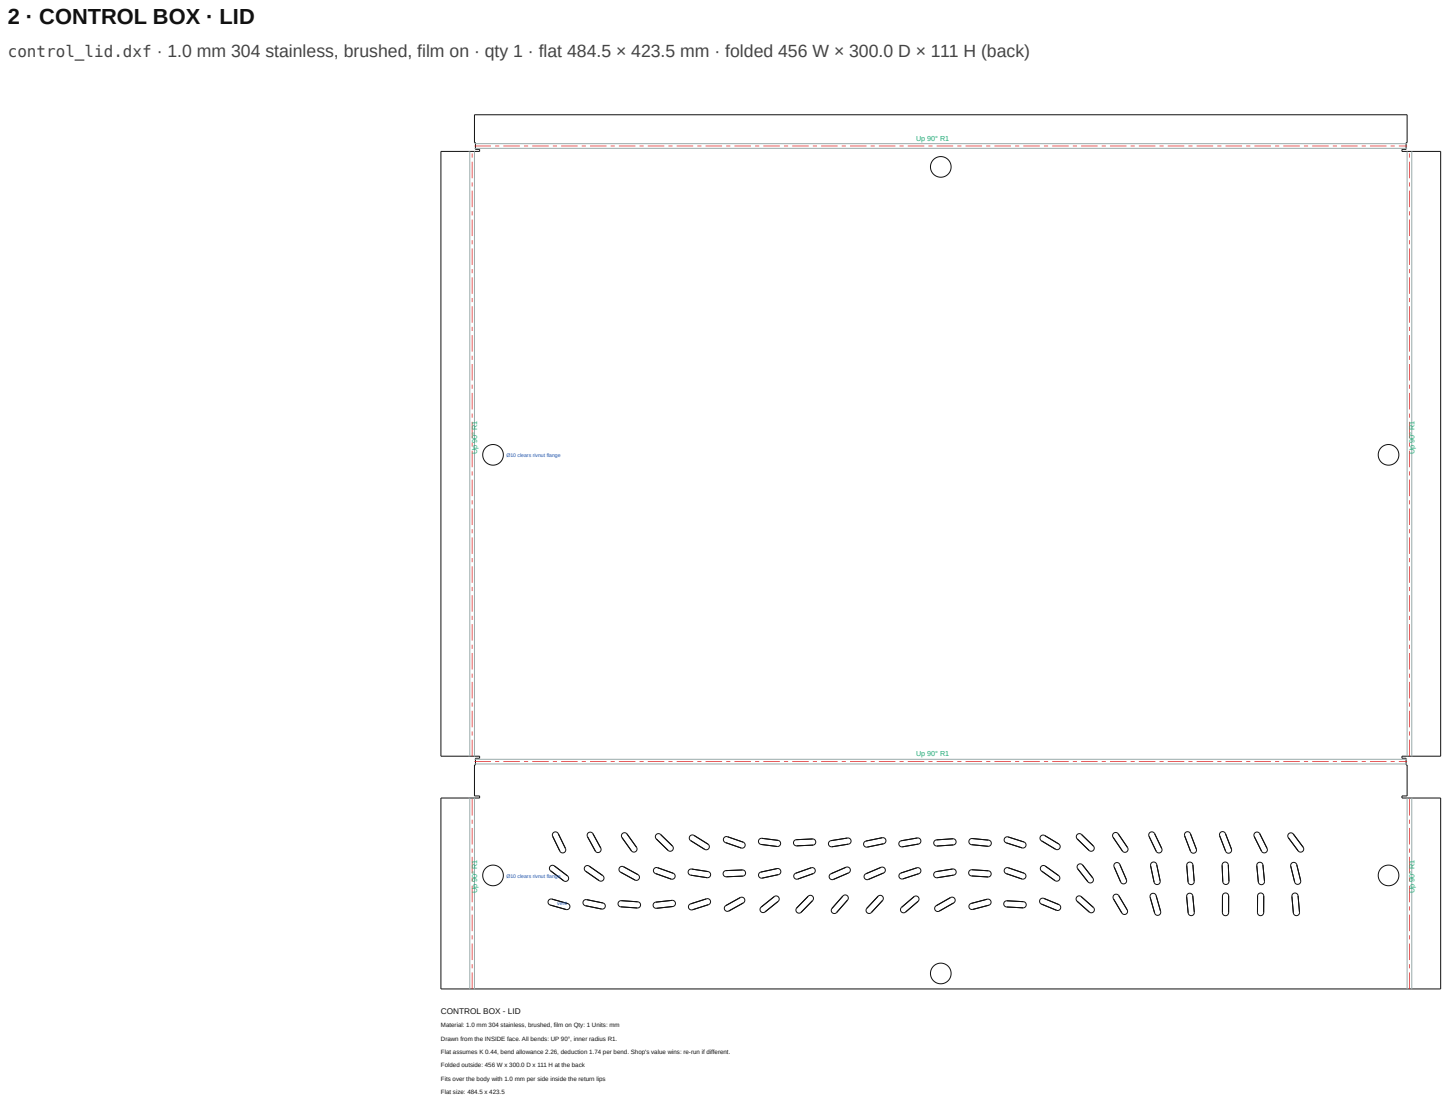
[picture p152: page 4]
vent; Flat size: 484.5 x 423.5

control_lid.dxf · 1.0 mm 304 stainless, brushed, film on · qty 1 · flat 484.5 × 423.5 mm · folded 456 W × 300.0 D × 111 H (back)

Ø10 clears rivnut flange

CONTROL BOX - LID

Material: 1.0 mm 304 stainless, brushed, film on Qty: 1 Units: mm

Drawn from the INSIDE face. All bends: UP 90°, inner radius R1.

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

Folded outside: 456 W x 300.0 D x 111 H at the back

Fits over the body with 1.0 mm per side inside the return lips

### 3 · CONTROL BOX · BASE PLATE

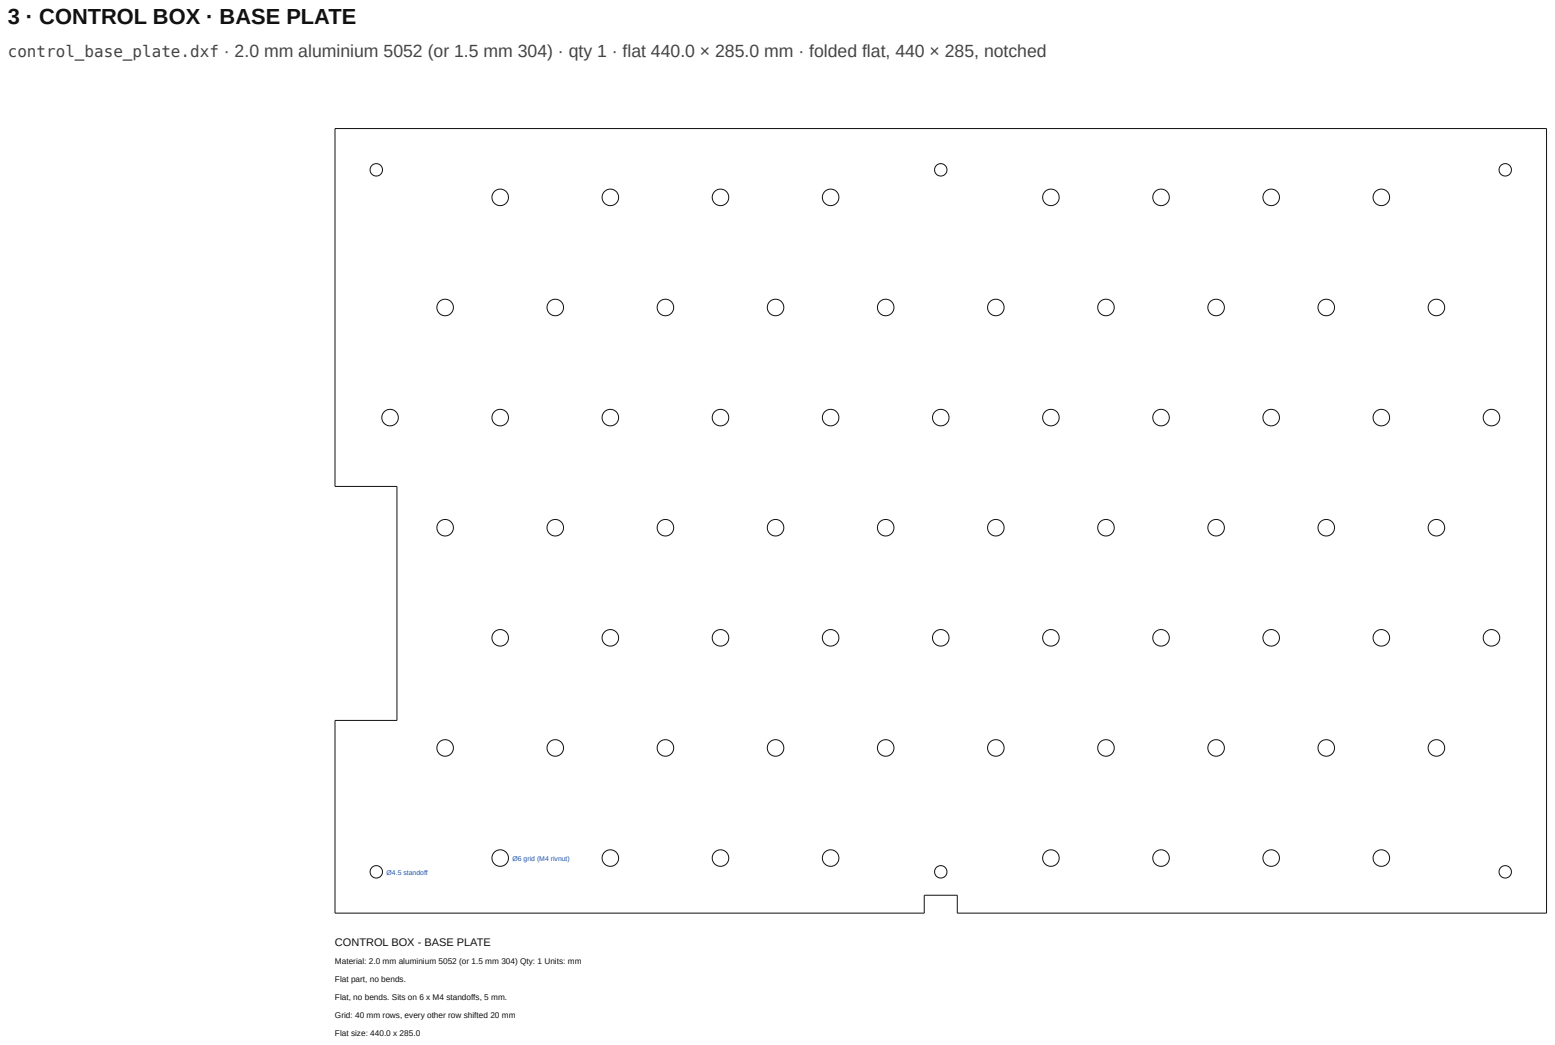
[picture p153: page 5]
Ø4.5 standoff; Ø6 grid (M4 rivnut); Flat size: 440.0 x 285.0

control_base_plate.dxf · 2.0 mm aluminium 5052 (or 1.5 mm 304) · qty 1 · flat 440.0 × 285.0 mm · folded flat, 440 × 285, notched

CONTROL BOX - BASE PLATE

Material: 2.0 mm aluminium 5052 (or 1.5 mm 304) Qty: 1 Units: mm

Flat part, no bends.

Flat, no bends. Sits on 6 x M4 standoffs, 5 mm.

Grid: 40 mm rows, every other row shifted 20 mm

### 4 · POWER BOX · BODY

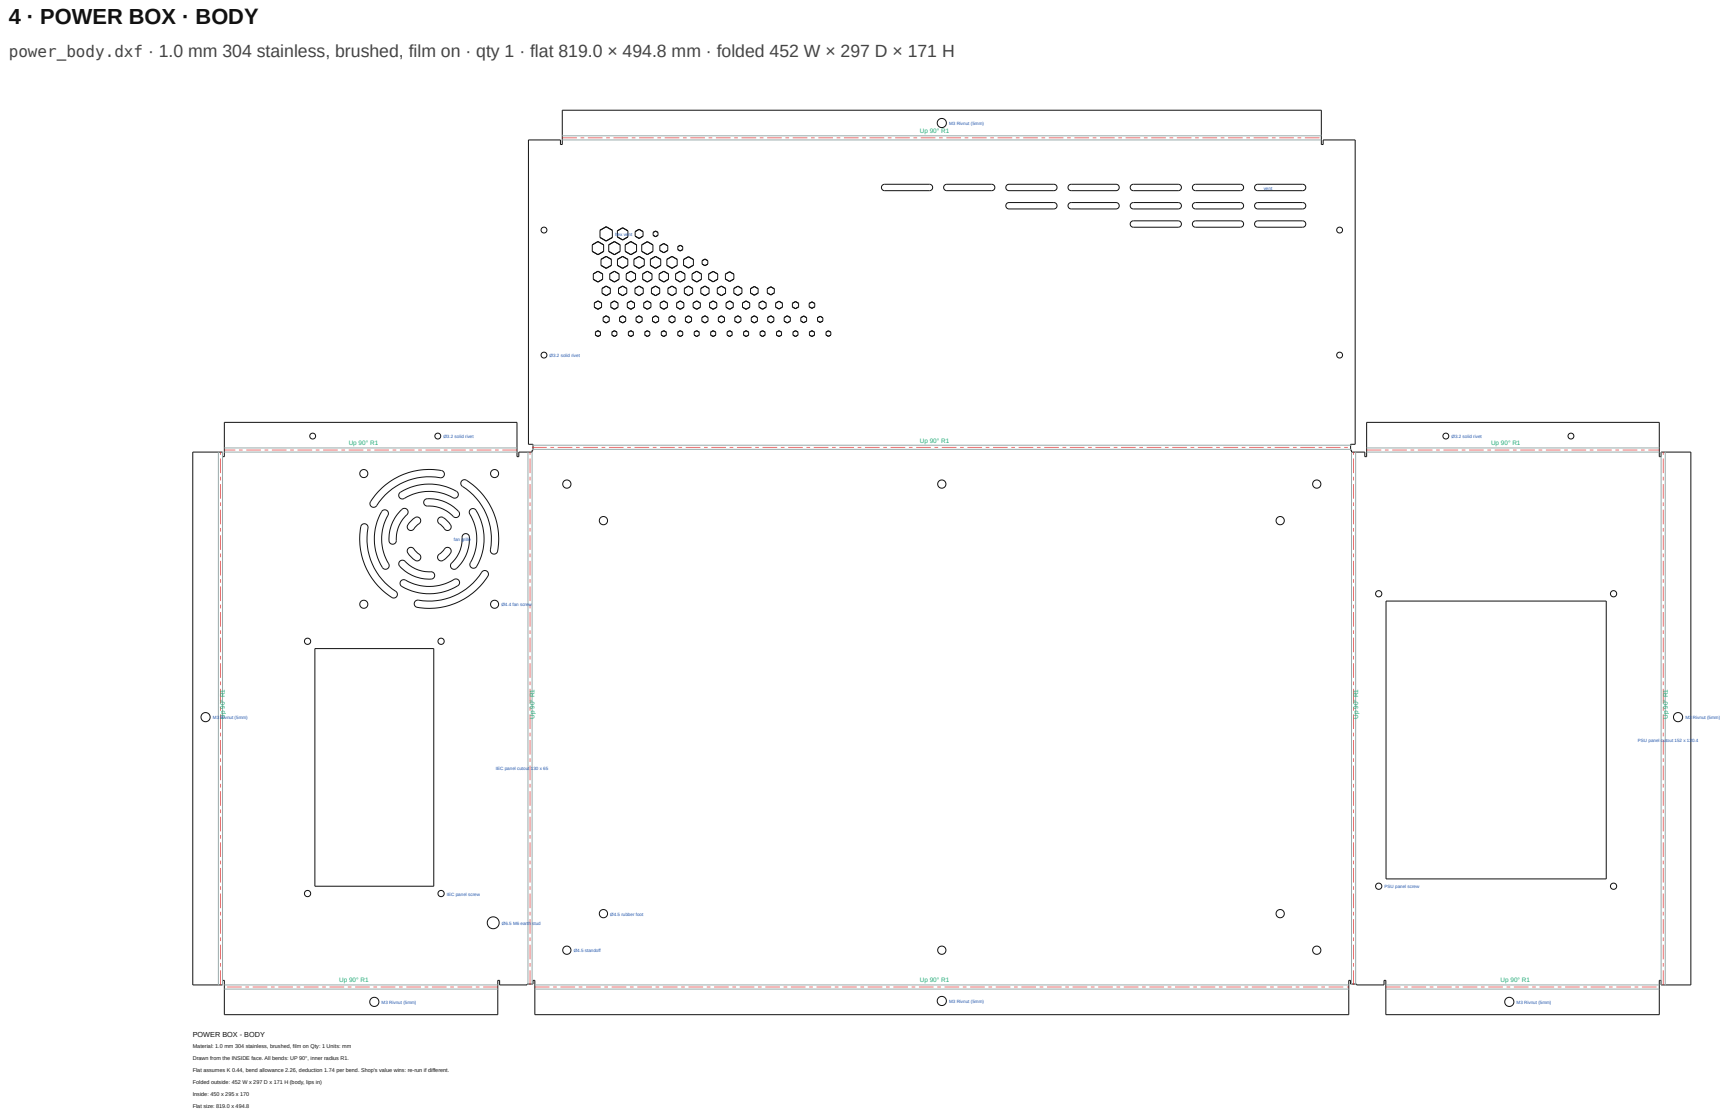
[picture p154: page 6]
Ø3.2 solid rivet; M3 Rivnut (5mm); Ø4.5 standoff; Ø4.5 rubber foot; vent; hex vent; fan grille; Ø4.4 fan screw; Ø6.5 M6 earth stud; Inside: 450 x 295 x 170; Flat size: 819.0 x 494.8

power_body.dxf · 1.0 mm 304 stainless, brushed, film on · qty 1 · flat 819.0 × 494.8 mm · folded 452 W × 297 D × 171 H

PSU panel cutout 152 x 120.4

IEC panel cutout 130 x 65

IEC panel screw

PSU panel screw

POWER BOX - BODY

Material: 1.0 mm 304 stainless, brushed, film on Qty: 1 Units: mm

Drawn from the INSIDE face. All bends: UP 90°, inner radius R1.

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

Folded outside: 452 W x 297 D x 171 H (body, lips in)

### 5 · POWER BOX · LID

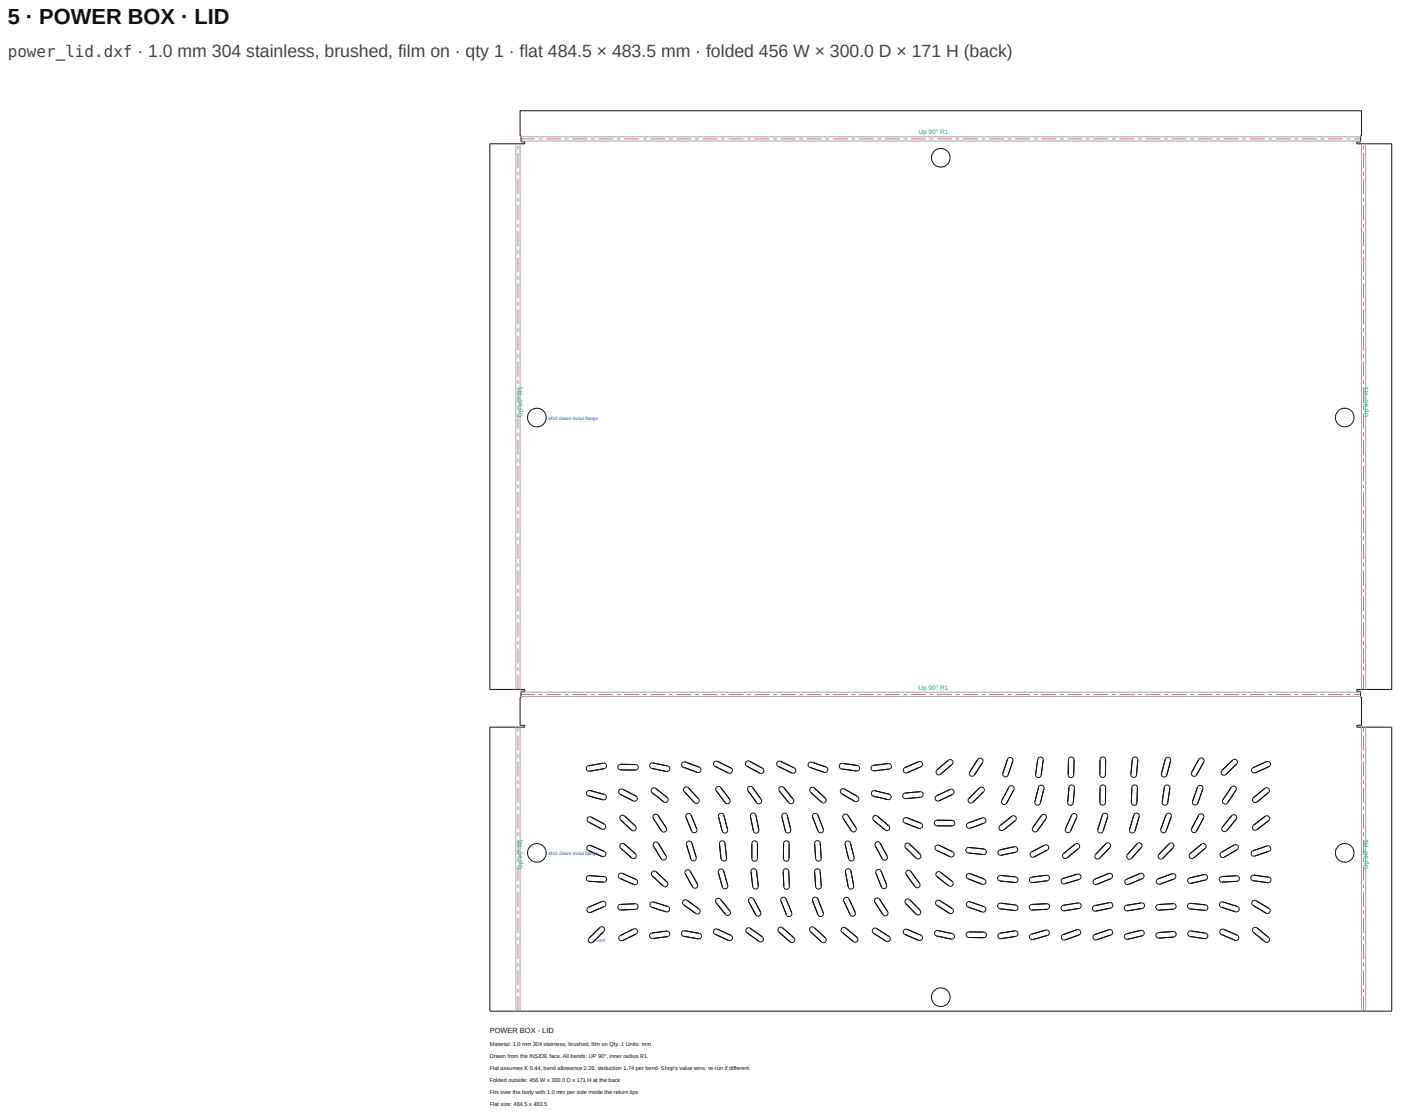
[picture p155: page 7]
vent; Flat size: 484.5 x 483.5

power_lid.dxf · 1.0 mm 304 stainless, brushed, film on · qty 1 · flat 484.5 × 483.5 mm · folded 456 W × 300.0 D × 171 H (back)

Ø10 clears rivnut flange

POWER BOX - LID

Material: 1.0 mm 304 stainless, brushed, film on Qty: 1 Units: mm

Drawn from the INSIDE face. All bends: UP 90°, inner radius R1.

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

Folded outside: 456 W x 300.0 D x 171 H at the back

Fits over the body with 1.0 mm per side inside the return lips

### 6 · POWER BOX · BASE PLATE

Ø4.5 standoff; Ø6 grid (M4 rivnut); Flat size: 440.0 x 285.0

power_base_plate.dxf · 2.0 mm aluminium 5052 (or 1.5 mm 304) · qty 1 · flat 440.0 × 285.0 mm · folded flat, 440 × 285, notched

POWER BOX - BASE PLATE

Material: 2.0 mm aluminium 5052 (or 1.5 mm 304) Qty: 1 Units: mm

Flat part, no bends.

Flat, no bends. Sits on 6 x M4 standoffs, 5 mm.

Grid: 40 mm rows, every other row shifted 20 mm
