smallwins128/pen-plotter/firmware/grbl-servo/config.h

#define config_h
#include "grbl.h" // For Arduino IDE compatibility.
#define DEFAULTS_GENERIC
#define CPU_MAP_ATMEGA328P // Arduino Uno CPU
#define BAUD_RATE 115200
#define CMD_RESET 0x18 // ctrl-x.
#define CMD_STATUS_REPORT '?'
#define CMD_CYCLE_START '~'
#define CMD_FEED_HOLD '!'
#define CMD_SAFETY_DOOR 0x84
#define CMD_JOG_CANCEL  0x85
#define CMD_DEBUG_REPORT 0x86 // Only when DEBUG enabled, sends debug report in '{}' braces.
#define CMD_FEED_OVR_RESET 0x90         // Restores feed override value to 100%.
#define CMD_FEED_OVR_COARSE_PLUS 0x91
#define CMD_FEED_OVR_COARSE_MINUS 0x92
#define CMD_FEED_OVR_FINE_PLUS  0x93
#define CMD_FEED_OVR_FINE_MINUS  0x94
#define CMD_RAPID_OVR_RESET 0x95        // Restores rapid override value to 100%.
#define CMD_RAPID_OVR_MEDIUM 0x96
#define CMD_RAPID_OVR_LOW 0x97
#define CMD_SPINDLE_OVR_RESET 0x99      // Restores spindle override value to 100%.
#define CMD_SPINDLE_OVR_COARSE_PLUS 0x9A
#define CMD_SPINDLE_OVR_COARSE_MINUS 0x9B
#define CMD_SPINDLE_OVR_FINE_PLUS 0x9C
#define CMD_SPINDLE_OVR_FINE_MINUS 0x9D
#define CMD_SPINDLE_OVR_STOP 0x9E
#define CMD_COOLANT_FLOOD_OVR_TOGGLE 0xA0
#define CMD_COOLANT_MIST_OVR_TOGGLE 0xA1
#define HOMING_INIT_LOCK // Comment to disable
#define HOMING_CYCLE_0 (1<<X_AXIS)
#define HOMING_CYCLE_1 (1<<Y_AXIS)
#define N_HOMING_LOCATE_CYCLE 1 // Integer (1-128)
#define HOMING_SINGLE_AXIS_COMMANDS // [PLOTTER EDIT 4] enables $HX and $HY
#define N_STARTUP_LINE 2 // Integer (1-2)
#define N_DECIMAL_COORDVALUE_INCH 4 // Coordinate or position value in inches
#define N_DECIMAL_COORDVALUE_MM   3 // Coordinate or position value in mm
#define N_DECIMAL_RATEVALUE_INCH  1 // Rate or velocity value in in/min
#define N_DECIMAL_RATEVALUE_MM    0 // Rate or velocity value in mm/min
#define N_DECIMAL_SETTINGVALUE    3 // Decimals for floating point setting values
#define N_DECIMAL_RPMVALUE        0 // RPM value in rotations per min.
#define MESSAGE_PROBE_COORDINATES // Enabled by default. Comment to disable.
#define SAFETY_DOOR_SPINDLE_DELAY 4.0 // Float (seconds)
#define SAFETY_DOOR_COOLANT_DELAY 1.0 // Float (seconds)
#define CHECK_LIMITS_AT_INIT
#define DEFAULT_FEED_OVERRIDE           100 // 100%. Don't change this value.
#define MAX_FEED_RATE_OVERRIDE          200 // Percent of programmed feed rate (100-255). Usually 120% or 200%
#define MIN_FEED_RATE_OVERRIDE           10 // Percent of programmed feed rate (1-100). Usually 50% or 1%
#define FEED_OVERRIDE_COARSE_INCREMENT   10 // (1-99). Usually 10%.
#define FEED_OVERRIDE_FINE_INCREMENT      1 // (1-99). Usually 1%.
#define DEFAULT_RAPID_OVERRIDE  100 // 100%. Don't change this value.
#define RAPID_OVERRIDE_MEDIUM    50 // Percent of rapid (1-99). Usually 50%.
#define RAPID_OVERRIDE_LOW       25 // Percent of rapid (1-99). Usually 25%.
#define DEFAULT_SPINDLE_SPEED_OVERRIDE    100 // 100%. Don't change this value.
#define MAX_SPINDLE_SPEED_OVERRIDE        200 // Percent of programmed spindle speed (100-255). Usually 200%.
#define MIN_SPINDLE_SPEED_OVERRIDE         10 // Percent of programmed spindle speed (1-100). Usually 10%.
#define SPINDLE_OVERRIDE_COARSE_INCREMENT  10 // (1-99). Usually 10%.
#define SPINDLE_OVERRIDE_FINE_INCREMENT     1 // (1-99). Usually 1%.
#define RESTORE_OVERRIDES_AFTER_PROGRAM_END // Default enabled. Comment to disable.
#define REPORT_FIELD_BUFFER_STATE // Default enabled. Comment to disable.
#define REPORT_FIELD_PIN_STATE // Default enabled. Comment to disable.
#define REPORT_FIELD_CURRENT_FEED_SPEED // Default enabled. Comment to disable.
#define REPORT_FIELD_WORK_COORD_OFFSET // Default enabled. Comment to disable.
#define REPORT_FIELD_OVERRIDES // Default enabled. Comment to disable.
#define REPORT_FIELD_LINE_NUMBERS // Default enabled. Comment to disable.
#define REPORT_OVR_REFRESH_BUSY_COUNT 20  // (1-255)
#define REPORT_OVR_REFRESH_IDLE_COUNT 10  // (1-255) Must be less than or equal to the busy count
#define REPORT_WCO_REFRESH_BUSY_COUNT 30  // (2-255)
#define REPORT_WCO_REFRESH_IDLE_COUNT 10  // (2-255) Must be less than or equal to the busy count
#define ACCELERATION_TICKS_PER_SECOND 100
#define ADAPTIVE_MULTI_AXIS_STEP_SMOOTHING  // Default enabled. Comment to disable.
#define TOOL_LENGTH_OFFSET_AXIS Z_AXIS // Default z-axis. Valid values are X_AXIS, Y_AXIS, or Z_AXIS.
#define VARIABLE_SPINDLE // Default enabled. Comment to disable.
#define MINIMUM_JUNCTION_SPEED 0.0 // (mm/min)
#define MINIMUM_FEED_RATE 1.0 // (mm/min)
#define N_ARC_CORRECTION 12 // Integer (1-255)
#define ARC_ANGULAR_TRAVEL_EPSILON 5E-7 // Float (radians)
#define DWELL_TIME_STEP 50 // Integer (1-255) (milliseconds)
#define ENABLE_RESTORE_EEPROM_WIPE_ALL         // '$RST=*' Default enabled. Comment to disable.
#define ENABLE_RESTORE_EEPROM_DEFAULT_SETTINGS // '$RST=$' Default enabled. Comment to disable.
#define ENABLE_RESTORE_EEPROM_CLEAR_PARAMETERS // '$RST=#' Default enabled. Comment to disable.
#define ENABLE_BUILD_INFO_WRITE_COMMAND // '$I=' Default enabled. Comment to disable.
#define FORCE_BUFFER_SYNC_DURING_EEPROM_WRITE // Default enabled. Comment to disable.
#define FORCE_BUFFER_SYNC_DURING_WCO_CHANGE // Default enabled. Comment to disable.
#define PARKING_AXIS Z_AXIS // Define which axis that performs the parking motion
#define PARKING_TARGET -5.0 // Parking axis target. In mm, as machine coordinate [-max_travel,0].
#define PARKING_RATE 500.0 // Parking fast rate after pull-out in mm/min.
#define PARKING_PULLOUT_RATE 100.0 // Pull-out/plunge slow feed rate in mm/min.
#define PARKING_PULLOUT_INCREMENT 5.0 // Spindle pull-out and plunge distance in mm. Incremental distance.
#define DISABLE_LASER_DURING_HOLD // Default enabled. Comment to disable.
#define N_PIECES 4  // Integer (1-4). Number of piecewise lines used in script solution.
#define RPM_MAX  11686.4  // Max RPM of model. $30 > RPM_MAX will be limited to RPM_MAX.
#define RPM_MIN  202.5    // Min RPM of model. $31 < RPM_MIN will be limited to RPM_MIN.
#define RPM_POINT12  6145.4  // Used N_PIECES >=2. Junction point between lines 1 and 2.
#define RPM_POINT23  9627.8  // Used N_PIECES >=3. Junction point between lines 2 and 3.
#define RPM_POINT34  10813.9 // Used N_PIECES = 4. Junction point between lines 3 and 4.
#define RPM_LINE_A1  3.197101e-03  // Used N_PIECES >=1. A and B constants of line 1.
#define RPM_LINE_B1  -3.526076e-1
#define RPM_LINE_A2  1.722950e-2   // Used N_PIECES >=2. A and B constants of line 2.
#define RPM_LINE_B2  8.588176e+01
#define RPM_LINE_A3  5.901518e-02  // Used N_PIECES >=3. A and B constants of line 3.
#define RPM_LINE_B3  4.881851e+02
#define RPM_LINE_A4  1.203413e-01  // Used N_PIECES = 4. A and B constants of line 4.
#define RPM_LINE_B4  1.151360e+03
#define DUAL_AXIS_SELECT  X_AXIS  // Must be either X_AXIS or Y_AXIS
#define DUAL_AXIS_HOMING_FAIL_AXIS_LENGTH_PERCENT  5.0  // Float (percent)
#define DUAL_AXIS_HOMING_FAIL_DISTANCE_MAX  25.0  // Float (mm)
#define DUAL_AXIS_HOMING_FAIL_DISTANCE_MIN  2.5  // Float (mm)
#define DUAL_AXIS_CONFIG_PROTONEER_V3_51    // Uncomment to select. Comment other configs.
