smallwins128/pen-plotter/settings/plotter.grbl.txt

$0=10
$1=255
$2=0
$3=1
$4=0
$5=1
$6=0
$10=3
$11=0.020
$12=0.002
$13=0
$20=0
$21=0
$22=1
$23=2
$24=50.000
$25=500.000
$26=100
$27=3.000
$30=180
$31=0
$32=0
$100=80.000
$101=80.000
$102=80.000
$110=500.000
$111=500.000
$112=500.000
$120=50.000
$121=50.000
$122=200.000
$130=400.000
$131=250.000
$132=200.000
