smallwins128/pen-plotter/tools/pentest.py

#!/usr/bin/env python3
"""pentest.py - find the largest pen swing the servo can make without resetting GRBL.

Homes first (so the steppers are energised, which is the condition the resets
happen under), then works through progressively larger up/down swings around a
centre point, cycling each one a few times. Stops at the first reset and tells
you the last swing that survived.

    python3 tools/pentest.py                    default sweep around S115
    python3 tools/pentest.py --centre 100       centre the swing elsewhere
    python3 tools/pentest.py --cycles 5         more repeats per swing
    python3 tools/pentest.py --no-home          skip homing (motors not energised)

Requires: pip3 install pyserial
"""

import argparse, re, sys, time

try:
    import serial
except ImportError:
    sys.exit("pyserial not installed.  Run:  pip3 install pyserial")

PORT = "/dev/cu.usbserial-A5069RR4"
BAUD = 115200
SWINGS = [6, 12, 18, 24, 30, 36, 42, 48, 54, 60]   # total spread, up to down
STATE_RE = re.compile(r"<([A-Za-z]+)[|>]")


class Reset(Exception):
    pass


class Link:
    def __init__(self, port, baud):
        print("Opening %s (resets the Arduino) ..." % port)
        self.ser = serial.Serial(port, baud, timeout=0.2)
        time.sleep(2.0)
        self.ser.reset_input_buffer()

    def line(self):
        return self.ser.readline().decode(errors="replace").strip()

    def write(self, s):
        self.ser.write(s.encode())
        self.ser.flush()

    def check_banner(self, s):
        if s.startswith("Grbl ") and "for help" in s:
            raise Reset()

    def cmd(self, c, timeout=20.0):
        self.write(c + "\n")
        end = time.time() + timeout
        while time.time() < end:
            s = self.line()
            if not s:
                continue
            self.check_banner(s)
            if s == "ok":
                return True
            if s.startswith("error") or s.startswith("ALARM"):
                print("      %s" % s)
                return False
        raise Reset()          # silence this long means it's gone

    def state(self, timeout=3.0):
        self.write("?")
        end = time.time() + timeout
        while time.time() < end:
            s = self.line()
            if not s:
                continue
            self.check_banner(s)
            if s.startswith("<"):
                m = STATE_RE.match(s)
                return m.group(1) if m else "?"
        return None

    def home(self):
        print("Homing ...")
        self.write("$H\n")
        end = time.time() + 300
        while time.time() < end:
            s = self.line()
            if not s:
                continue
            self.check_banner(s)
            if s == "ok":
                print("   homed.\n")
                return True
            if s.startswith("ALARM") or s.startswith("error"):
                print("   !! %s" % s)
                return False
        return False

    def close(self):
        self.ser.close()


def main():
    ap = argparse.ArgumentParser()
    ap.add_argument("--port", default=PORT)
    ap.add_argument("--centre", type=int, default=115,
                help="middle of the swing (default 115, midway between pen down 90 and up 140)")
    ap.add_argument("--cycles", type=int, default=3, help="up/down repeats per swing")
    ap.add_argument("--dwell", type=float, default=0.3)
    ap.add_argument("--no-home", action="store_true")
    args = ap.parse_args()

    link = Link(args.port, BAUD)
    survived, failed_at = None, None

    try:
        if not args.no_home:
            if not link.home():
                print("Homing failed -- run with --no-home to test anyway.")
                return
        else:
            link.cmd("$X")

        st = link.state()
        print("State before testing: %s" % st)
        if st != "Idle":
            print("!! Expected Idle. Stopping so we test from a known state.")
            return

        print("\n  swing    down    up     result")
        print("  ---------------------------------")

        for swing in SWINGS:
            half = swing // 2
            down, up = args.centre - half, args.centre + half
            if down < 0 or up > 180:
                break
            print("  %-7d S%-6d S%-5d " % (swing, down, up), end="", flush=True)
            try:
                for _ in range(args.cycles):
                    link.cmd("M3 S%d" % up)
                    link.cmd("G4 P%.2f" % args.dwell)
                    link.cmd("M3 S%d" % down)
                    link.cmd("G4 P%.2f" % args.dwell)
                st = link.state()
                if st in ("Alarm", None):
                    raise Reset()
                print("ok")
                survived = (swing, down, up)
            except Reset:
                print("RESET")
                failed_at = (swing, down, up)
                break

        print()
        if failed_at and survived:
            print("Largest swing that survived: %d units  (down S%d / up S%d)"
                  % survived)
            print("First swing that reset:      %d units  (down S%d / up S%d)"
                  % failed_at)
            print("\nUse a swing at or below %d for now. One PWM step is about 6 units,"
                  % survived[0])
            print("so %d units is roughly %d distinct servo steps of lift."
                  % (survived[0], survived[0] // 6))
        elif failed_at:
            print("Reset on the very first swing (%d units). Even the smallest pen"
                  % failed_at[0])
            print("movement trips it -- the supply has no margin at all.")
        elif survived:
            print("No resets at any swing up to %d units. The servo is not the"
                  % survived[0])
            print("limiting factor at this centre point.")
    except Reset:
        print("\n!! GRBL reset before the sweep could finish.")
    except KeyboardInterrupt:
        print("\ninterrupted")
    finally:
        link.close()


if __name__ == "__main__":
    main()
