smallwins128/pen-plotter/(commit log)

2026-08-23 Add full setup docs, GRBL settings, bring-up tests and servo tuning tool
    The pen lift has never worked because stock GRBL 1.1 drives D11 at 980 Hz
    (1/64 prescaler on Timer2), which no RC servo can decode. No G-code sender
    can fix that. docs/FIRMWARE_SERVO.md gives the four source edits that do:
    a 1/1024 prescaler for a 61 Hz servo frame, an S->pulse mapping onto
    0.5-2.5 ms, a homing cycle that does not try to home a nonexistent Z, and
    single-axis homing commands for safe bring-up.
    Also documents the D11/D12 swap that VARIABLE_SPINDLE performs (servo signal
    goes on the header silkscreened "Z endstop"; the header silkscreened "SpnEn"
    is what GRBL reads as the Z limit), the endstop wiring for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
    [plotter.grbl.txt]
2026-08-23 Add patched GRBL 1.1h firmware, ready to flash
    grbl-servo-plotter.zip installs via Arduino IDE > Add .ZIP Library. Five
    edits against stock gnea/grbl, each tagged [PLOTTER EDIT n] in the source:
    Timer2 to a 61 Hz servo frame, S0-S180 mapped onto 512-2496 us pulses,
    homing cycle changed to X-then-Y for a machine with no Z switch, $HX/$HY
    enabled, and a build stamp so $I identifies the firmware.
    Compile-tested for atmega328p: clean build, 30700 bytes text.
    Claude-Session: https://claude.ai/code/session_01WJ2WTpHZk1dpfNxWLSPL7Y
    [config.h, cpu_map.h, defaults.h]
2026-08-23 Set tuned pen values: S60 down, S120 up
    Measured on the machine after the servo firmware fix.
    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
2026-08-23 Add plot2.py sender: homes and streams in one connection
    plot.py cannot combine a command with a file, and its 10s reply timeout
    trips on any long move - GRBL withholds ok until buffer space frees, so a
    300mm rapid legitimately goes quiet for ~9s and gets misread as a reset.
    plot2.py homes by default (opening the port resets the Arduino, so homing
    must happen in the same connection as the plot), waits on ? polling rather
    than a fixed timeout, streams with character-counting flow control, and
    detects a genuine reset by the GRBL banner rather than by silence.
    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
    [plot2.py]
2026-08-23 plot2.py: refuse to stream when the G54 work offset is zero
    A wiped EEPROM leaves G54 at zero, which turns X0 Y0 in a drawing file into
    machine zero - the homed corner. The gantry then drives into its end stops
    and stalls, and the resulting current surge resets the board, which reads as
    an electrical fault rather than the crash it is.
    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
    [plot2.py]
2026-08-23 Add T8: small-swing servo square to test current-pulse hypothesis
2026-08-23 Add pentest.py: sweep pen swings to find the largest the supply tolerates
    Homes first so the steppers are energised - the condition under which the
    resets occur - then cycles progressively larger up/down swings, stopping at
    the first reset and reporting the last swing that survived.
    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
    [pentest.py]
2026-08-23 plot2.py: add --lockstep to stream one line at a time
    Isolates the streaming protocol as a variable: pentest.py sends strictly one
    command per ok and never fails, while buffered streaming of the same commands
    does. Lockstep runs the identical file the pentest way.
    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
    [plot2.py]
2026-08-23 plot2.py: fix AttributeError in lockstep mode (write -> _write)
    [plot2.py]
2026-08-23 Add T10: settle dwells before each pen command
    Every failing run actuates the servo immediately after a move completes;
    every passing run actuates it with no preceding motion. T10 inserts a
    1s dwell before each M3 to test whether recovery time is the variable.
2026-08-23 Add T11: soft-start servo ramp
    pentest.py never exercised the failing case - its first command lands near
    centre, so every jump it measures is from an already-energised servo. Real
    files open with M3 S120, asking a limp servo to snap to an extreme in one
    step. T11 walks it up in stages instead.
2026-08-23 Add T12: release the servo with M5 while drawing
    Failures now occur during moves while the servo holds position. M5 disconnects
    the PWM pin so it draws nothing during the strokes; the pen rests down under
    its own weight.
2026-08-23 Fold bring-up findings back into SETUP.md and README
    Servo ground wire marked mandatory, soft-start added to the file preamble,
    the PSU-off rule for EEPROM writes, and G10 L2 preferred over L20 for setting
    work zero without motion.
2026-08-23 Add Hilbert curve artwork: 150mm single stroke, relative, no pen lifts
    Cell size chosen as an exact whole number of microsteps so 1023 relative
    moves accumulate no rounding drift.
2026-08-23 Record that the servo is an MG996R and resize the fix accordingly
    ~2.5 A stall rather than ~700 mA, and rated to 7.2 V. Capacitor goes to 2200 uF,
    buck back to 6.0 V, power pair to 20 AWG.
2026-08-23 Add spirograph rosette overlay: 150mm single stroke, starts and ends at centre
2026-08-24 Add four more single-stroke designs, none in the spirograph family
    - Gosper (flowsnake) curve, order 4: hexagonal space-filler, organic texture
    - Dragon curve, order 11: angular self-similar fractal, lines touch not cross
    - Sierpinski arrowhead, order 7: triangular lattice from one line
    - One-line labyrinth: random spanning tree of a 16x16 grid traced around its
    outline. A tree has no cycles, so its outline is a single closed curve -
    the whole maze draws without the pen leaving the paper.
    Each header states where to place the pen, derived from the measured extents
    rather than assumed: three of the four draw downward from their start point.
2026-08-24 Add HANDOFF.md and sync the settings block to the live machine
    docs/HANDOFF.md is the context doc to paste into a fresh session: current
    verified state, the D11/D12 pin swap, the mandatory servo ground wire, the
    three workflow rules (home in the same connection, G10 L2 for work zero, a
    zero G54 crashes the machine), and the open servo-supply problem with what
    has already been ruled out.
    settings/plotter.grbl.txt now matches what $$ actually returns rather than
    the pre-commissioning guesses - homing on, speeds and acceleration held low
    while the resets are unresolved, travel limits flagged as estimates.
    [plotter.grbl.txt]
2026-08-24 Add interference-field art generator and the first dense multi-colour pieces
    The look is a few hundred near-parallel lines warped by a wave field, plotted
    twice in different inks so the layers moire. It needs no pen lift at all, which
    is why it is the right thing to plot while the servo supply is unresolved.
    tools/fieldart.py generates the G-code and a matching SVG preview. Two design
    rules make it work on this machine:
    - one continuous stroke, nothing but G1 - no Z, no M2, no M5, no M3
    - every layer sweeps up the square and back down between its own rows, so it
    both doubles the line density and returns the carriage to its start point
    That closure is the registration method: when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
    [fieldart.py]
2026-08-24 Calm the field designs down: add fold and scale controls, reship the art
    --fold sets how many times the field wraps back on itself, which is what
    decides the number of dark ridges, and --scale stretches every wavelength so
    the surviving features are broad. Between them they are the turbulence dial the
    first pass did not have.
    Replaces the busy eddy/drift pieces with field_calm (two layers, one broad dome
    and a few clean ridges over open surface) and field_swell, both at fold 0.70-0.75
    and scale 1.3-1.6. They are also shorter: 36 m and ~73 minutes a layer against
    47 m and ~94. The proof run is down to 9 minutes.
    All four files re-verified: they close exactly on their start point and contain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
    [fieldart.py]
2026-08-24 Add an 18 cm piece in blue and red, plus --height and --inks
    --height separates the stack height from the row length, which is what it takes
    to land on an exact paper size: the waves overshoot the stack by about --amp at
    each end, so a 180 mm square is --size 180 --height 174. Verified: the drawn
    extent is 180.0 x 179.8 mm.
    --inks names the layer files after the pen that goes in the holder rather than
    L1/L2, and colours the SVG previews to match.
    180 mm is inside the machine's travel but past the ~150 mm that HANDOFF calls
    comfortable and nothing that large has been plotted here yet, so this also ships
    field_18cm_proof: the same field, coarse, covering the full extent in 13 minutes.
    [fieldart.py]
2026-08-24 HANDOFF: document how the collaboration actually works
    Claude has no access to the machine - it runs in a cloud container, so every
    physical action goes through the user. A fresh session that doesn't know this
    wastes time proposing things it cannot do.
    Records the working pattern: files arrive as attachments to save next to
    plot2.py, commands come one copy-pasteable line at a time, and code is never
    handed over to edit. Also what to send back - the command, the complete
    verbatim output, and what the machine physically did, since GRBL reports
    success just as happily when the gantry is jammed against the frame.
2026-08-24 Stop citing $130/$131 as evidence that 180 mm fits
    The merged HANDOFF section records that those two values were invented rather
    than measured, and names them as an example of a guess that later got treated as
    fact. FIELD_ART did exactly that: it offered them as proof the machine has room
    for an 18 cm piece. It does not prove anything.
    Replaces the claim with what is actually known - ~150 mm is the comfortable area,
    nothing larger has been plotted here, soft limits are off so nothing stops a run
    at the frame - and says to measure the free travel by hand first.
2026-08-24 Record the 180 mm motion-only reset, and add a 144 mm blue/red pair
    The 18 cm proof reset at line 284 with the servo disconnected - 52 moves past
    the first turnaround, so the stream had been driven out to X=+180. FINDINGS said
    motion alone was fine, but that rested on T7, a 50 mm square; nothing had ever
    traversed 180 mm.
    Two candidates and no way to separate them from here: the carriage jammed at the
    end of its X travel (ok means buffered, not executed, so GRBL would report a
    clean turnaround either way), or a real supply sag at the reversal. The free X
    travel, measured by hand, settles it.
    Meanwhile field_safe144_blue/red - the same design at 144 x 143.8 mm, inside the
    area the machine i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
2026-08-24 Add T14/T15: isolate the row-end reversal as the reset trigger
    A second reset at line 1116 landed within ~50 moves of a turnaround, same as
    the first at line 284. ok runs about 20 moves ahead of the machine, so the
    carriage was physically in the turn both times - while row 0 of the 18 cm proof
    ran 180 mm dead straight without trouble. Long traverses are not what hurts;
    reversing is.
    A serpentine turn reverses both X motors at once, which swings the A4988 coil
    currents full-scale - the largest dI/dt the 24 V rail sees - and the clone shield
    has almost no bulk capacitance. That makes queued fix #2 the priority, not the
    servo cap, since the servo is not even connected.
    T14 does 20 sharp rever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
2026-08-25 Correct 7a: the reversal was not the trigger, and the Arduino runs on USB
    A third reset at line 3014 landed 70 moves from the nearest turnaround, mid-row.
    With rows 181-226 moves long a random point averages ~45 moves from a turn, so
    52, 20 and 70 is scatter. The earlier draft called the reversal the trigger on
    two points; three do not support it, and the section now says so rather than
    quietly dropping it.
    What the three do show is duration - roughly 27 s, 107 s and 290 s - which is an
    intermittent fault rather than any particular move.
    Also promotes a detail already recorded in HANDOFF but not carried into the
    reasoning: the Arduino is USB-powered and the shield never feeds VIN, so a sag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
2026-08-26 Add a purchase list tied to the failures on record
    Groups parts by which documented failure each one addresses rather than by
    category, and leads with the two free tests that could delete half the list -
    the PSU-off stream and a borrowed USB cable.
    Top of the list is a multimeter, because Vref has never been measured on any of
    the three drivers, and a USB cable and isolator, because the Arduino runs on USB
    power and that path has never been tested. Then the fixes FINDINGS already
    queued: bulk capacitance at the servo and across the shield's 24 V terminals,
    twisted shielded stepper cable, 20 AWG servo power.
    Also says what not to buy: the Mean Well LRS-350-24 has an order of magnitude of
    he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
2026-09-01 Add control box design: one inlet, one 24 V rail, 19-wire panel interface
    Design for an enclosure holding the PSU, Uno and shield, presenting every
    machine wire on a keyed panel connector.
    The three supplies in the original sketch collapse to one. The Arduino needs
    no supply (it runs on USB and must keep the USB data link regardless, so a
    second 5 V source only fights its regulator); the endstops need none (bare
    switches on GRBL's internal pull-ups); and the servo's 6 V was always going
    to be a DC-DC, since no one makes a 6 V mains PSU. What is left is one 24 V
    brick, one fused distribution block, one 0 V star point — common grounds
    become a property of the topology rather than something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
2026-09-01 Add laser-cut enclosure: parametric flat patterns and a perforated base
    Sized around the Ender's own PSU. The stock Ender-3 Pro/V2 supply is a
    genuine Mean Well LRS-350-24, 215 x 115 x 30 mm, so the box becomes
    350 x 220 x 75 interior rather than the ~260 x 200 an LRS-100 would need.
    Reusing it costs volume and nothing else; the doc still says to read the
    label, because the 2018 Ender-3 shipped with more than one supply.
    tools/enclosure_dxf.py writes both blanks, the adapter plates and an SVG
    preview from one set of parameters. No dependencies.
    The design answer to "we don't know some of these dimensions" is that the
    base carries no component-specific mounting holes at all - just 104 holes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
2026-09-01 Default to a bought LRS-100-24; add a connector fit check and PSU presets
    "Which PSU do we know the size of" has a subtler answer than it looks. The
    LRS-350's datasheet is not less reliable than any other - 215 x 115 x 30 is
    solid. The open question is which unit is actually in the printer, since
    the 2018 Ender-3 shipped more than one part. Buying a specific part new is
    what closes that, not a better datasheet.
    So the default is now the Mean Well LRS-100-24: 24 V 4.5 A, 129 x 97 x 30,
    case 238A, 2.2x margin on the 2.0 A load. Box drops from 350 x 220 to
    265 x 200 x 75, base blank from 500.7 x 370.7 to 415.7 x 350.7.
    Rejected LRS-50-24 (2.2 A against a 2.0 A load is no margin) and LRS-75-24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
2026-09-03 Add generative art scope, a browser studio, and an SVG to G-code bridge
    vsketch is the right engine and we should not rebuild it. Checked against
    the source, not the README: vsk.stroke(n) is one layer per pen, vsk.text()
    uses Hershey single-stroke fonts with wrapping and justification, and
    vsk.vpype("linemerge ... linesort") is the plot-time optimisation that
    decides whether a contour plot takes 10 minutes or an hour.
    Its one real gap is output: vsk.save() writes SVG or HPGL, never G-code.
    HPGL is for old HP pen plotters, not GRBL. So the missing piece was never a
    framework, it was a writer.
    tools/svg2gcode.py is that writer. Layered SVG in, one G-code file per
    layer out, in the dialect SE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
    [svg2gcode.py]
2026-09-03 Add a UGS quickstart for hand-testing the plotter
    UGS is the fastest way to jog, work the pen and run a short test file by
    hand, but it has known failure modes on this machine and a couple of its
    default buttons are actively dangerous here. Document both.
    - docs/UGS.md: connect, unlock, work offset, jog, pen, one short file.
    Covers the buttons to avoid (Return to Zero sends a Z word, Reset Zero
    can zero G54 at the homed corner and turn X0 Y0 into the end stops),
    the local-disk rule for files, and the pen-lift reset so a mid-session
    reset reads as the known fault rather than a new one.
    - settings/ugs-macros.txt: copy-paste macro list, including the servo
    soft-start and the G10 L2 w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
2026-09-03 Fix wrong boot output in UGS.md and add an alarm reference
    UGS.md claimed GRBL emits "ALARM:9" on boot with $22=1 and that it is
    correct to ignore. It does not: it enters the Alarm *state* and prints
    [MSG:'$H'|'$X' to unlock]. ALARM:9 is a real homing failure - the limit
    switch was not found within the search distance - so the doc was telling
    the reader to clear the one alarm they should read.
    - Separate the Alarm state (normal on connect, no number) from a numbered
    ALARM:n in the console (a fault).
    - Add section 7: what each alarm number means on this machine, and a
    four-step ladder for ALARM:9 - homing direction, whether the axis moved
    at all, the Pn: field for switch continuity, al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
2026-09-03 Add T14: 20 mm square repeated for ten minutes
    A soak test. The short squares prove the machine moves; nothing in the
    suite proves it keeps moving, which is where lost steps, belt slip and
    thermal driver faults actually show up.
    58 laps of a 20 mm square, pen free and relative: no work offset needed,
    never approaches X0 Y0, and every lap returns to its own start point so
    accumulated drift is measurable against a mark on the bed. No servo
    commands at all, so a reset during this run rules the pen lift out as
    the cause.
    Lap count is calculated from $110=500 and $120=50 (10.27 s/lap, 9:55
    total) assuming a full stop at each corner - flagged in the header as
    calculated rather than measured, to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
2026-09-04 Fix servo_sweep.py silently doing nothing in the Alarm state
    The sweep never sent $X. With $22=1 GRBL boots into Alarm and refuses
    G-code with error:9, M3 included - and the M3 was sent with quiet=True,
    so the refusals were invisible. The tool printed every S value, pwm count
    and pulse width exactly as if it were working while the servo sat still.
    Reported from the machine: two error:9 lines at startup from G21/G90, and
    a pen that never moved.
    Unlocking in a separate command cannot fix it - opening the port resets
    the Arduino straight back into Alarm - so the $X has to be in the same
    connection.
    - Send $X on connect, before G21/G90.
    - Stop swallowing refusals: check the M3 reply and say pl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
    [servo_sweep.py]
2026-09-04 Record a servo reset with no motion involved, at S180
    Observed on the machine during a sweep: S180 held for a few seconds
    resets the board, with the gantry stationary and no move sent in that
    connection. Every reset logged until now needed a preceding move, so
    this narrows the open problem in section 7 rather than restating it.
    S180 is the end of the horn's mechanical travel on the current linkage,
    so the servo is stalled against its stop drawing full current for as
    long as the signal holds - a sustained load, not a transient, which the
    buck's transient response alone does not explain.
    Also records the post-arm-change geometry (S90 pen down, arm down; S180
    pen up, arm right - a 90 degree s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
2026-09-04 Set measured pen values: S160 up, S120 down
    Measured on the machine with servo_sweep.py after the arm change. S155
    is where the pen first lifts clear; S160 leaves margin. The old S120 up
    / S60 down pair predates the arm and is now wrong in both directions.
    S120 changes meaning in this commit - it was pen up, it is now pen down -
    so the substitution was done in a single atomic pass across all files
    rather than sequentially, which would have double-converted S60 through
    S120 to S160.
    - gcode/tests: 12 files remapped. Soft-start ladders become
    120 -> 133 -> 146 -> 160; T8's small-swing pair becomes 135/120, still
    ~15 units and still deliberately short of lifting the pen.
    - tools: plot2.py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
    [pentest.py, plot2.py, servo_sweep.py]
2026-09-04 Re-set pen values to S90 down / S140 up, and add T15
    The servo horn was re-aligned on its spline, so the pair set earlier
    today (S120 down / S160 up) no longer describes the machine. Remapped
    across the 12 test files, plot2.py, pentest.py, servo_sweep.py, the UGS
    macros and the docs. The soft-start ladder returns to waking at S90,
    which is pen down again and the gentlest place to energise a limp servo;
    the ladder is now 90 -> 107 -> 123 -> 140.
    FINDINGS 7a is scoped rather than deleted: the S180 stall was observed on
    the previous alignment, so the number is specific to that setup while the
    mechanism - a horn driven into its stop stalls the servo and resets the
    board, moving or not - still h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
    [pentest.py, plot2.py, servo_sweep.py]
2026-09-04 Record T15's first run: resets at cycle 12, in 30 seconds
    Reset on stream line 91 - M3 S90, pen down - with line 90 a G0 X-5.0
    move. That is section 7's signature unchanged: the servo actuating after
    a move. The re-aligned arm and the new S values did not affect it, and it
    was not the first energisation either; 11 cycles completed first.
    The new part is the measurement, not the fault. Every earlier
    reproduction was "somewhere in a long job"; T15 fails at a countable
    cycle number in about half a minute, which gives the open problem a
    metric - dies at ~12 of 140 today, so a fix reaching 40 is visible
    progress and 140 is the answer. It also makes "change one thing at a
    time" cheap enough to ac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
2026-09-07 hardware: parametric CAD in build123d, starting with the 2040 frame
    Sets up hardware/ as code-CAD so physical parts get the same treatment as
    the G-code conventions: a diff with a reason attached, rather than an
    opaque STL. build123d drives OpenCASCADE, so these are real solids and
    export to STEP.
    First part is the outer frame: 2040 extrusion, 1000 x 600 mm outer, butt
    joints with the X rails full length. Comes out at 3.12 m of stock and
    ~4.1 kg.
    profiles.py models the 20-series T-slot section parametrically and is the
    building block for anything else made of extrusion. Its channel tapers
    from SLOT_INNER_W back to SLOT_ROOT_W at full depth -- that taper is what
    leaves the diagonal webs joi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
2026-09-07 hardware: 2020 cross bar, assembly, and an interactive 3D viewer
    Adds the moving gantry beam: 700 mm of 2020 spanning Y, riding the two
    1000 mm frame rails, with the whole thing travelling in X. Frame and bar
    share one datum, so parts/assembly.py is just a collection.
    Adds section_moments() to profiles.py, computed from the modelled
    polygon rather than looked up. It checks out against a solid 20x20
    square (13333.3 mm^4) and gives the 2020 section Ix = 7706 mm^4, in the
    right band for real 20-series. That makes the deflection question
    answerable rather than a guess: over the 580 mm supported span, the bar
    sags 0.014 mm under its own weight and 0.030 mm more under a 0.4 kg
    carriage. 0.044 mm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
2026-09-07 hardware: base deck, and the plate maths that says how to mount it
    Adds the steel base sheet across the frame footprint, with M5 clearance
    holes on the four rail centrelines for drop-in T-nuts. The frame and
    cross bar now stand on it via FRAME_BASE_Z, so the writing surface is at
    Z = DECK_T rather than Z = 0.
    The sheet has to be continuously supported by the tabletop, and
    plate_sag() is in the repo so that is a number rather than an opinion.
    Simply supported over the 960 x 560 mm frame opening, under nothing but
    its own weight, a 1.5 mm sheet sags 13.4 mm; 2 mm sags 7.5 mm; holding
    half a millimetre across that span needs roughly 8 mm of plate, 33 kg of
    it. So the sheet inherits the tableto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
2026-09-09 hardware: real gantry plate footprint, approximate gantry rise
    Plate drawing gives 65.5 mm square, 3 mm thick, R3 corners, 12x 5.10 and
    3x 7.20 holes, so GANTRY_PLATE_LEN drops from the 80 mm placeholder to
    65.5 and X travel goes 920 -> 934.5 mm. The three-wheel pattern also
    confirms the rails are V-slot, not the T-slot the section models.
    GANTRY_RISE goes 6 -> 15 mm. This one is eyeballed at 1-2 cm rather than
    measured, and is marked APPROXIMATE rather than TO CONFIRM: good enough
    to lay the machine out, not good enough to drill against. The cross bar
    underside now sits at Z 56.5.
    Claude-Session: https://claude.ai/code/session_01H5VGir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
2026-09-09 hardware: model the bench, machine parked at its left end
    Adds the 5 ft x 600 mm table top the machine stands on, with the machine
    hard against the left end so the 524 x 600 mm remainder is visible as the
    place the electronics go. Only the top is modelled -- nothing mounts to
    the legs, and the deck rests on the top face, so that is the only surface
    carrying a dimension anything depends on.
    Depth is taken as a round 600 to match the machine; a true 2 ft is
    609.6 mm, which would leave about 5 mm each side instead of flush.
    The viewer's old "tabletop outline" was a 1000 x 600 line standing in for
    the LINNMON, which this design removes. Replaced with the real bench, and
    the camera recentred si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
2026-09-09 hardware: electronics enclosure frame with stand-in contents
    A 450 x 320 x 200 mm 2020 box bolted alongside the machine (option B --
    its own four uprights, not sharing the machine's right-hand rail, so
    either can move without dismantling the other). Sits at X +510..+960,
    leaving 64 mm of bench beyond it.
    Contents are stand-in blocks at real outside dimensions rather than
    detailed parts: the two 24 V supplies, Uno + shield, the LM2596, two
    12-way lever rails, and the panel-mount IEC inlet with its mains
    splitters. 599 cm^2 on a 410 x 280 mm floor, 52% packed. Covers, joining
    plates and wiring are all still absent by intent.
    check_layout() runs on every build and fails if any block leaves th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
2026-09-09 hardware: colour enclosure contents by material
    Each stand-in block now carries a material tag, and the viewer exports one
    mesh per material so they can be coloured separately: the two PSUs in the
    same steel as the base deck, Uno and buck in PCB green, the lever rails
    and IEC block in ABS white. Grouped under the one toggle, and the material
    is shown with a swatch in the contents table.
    The tag only drives colour. The blocks are still stand-ins, so it is there
    to make the box readable at a glance rather than to describe the part.
    Claude-Session: https://claude.ai/code/session_01H5VGirteDv17nc4HVKRm7N
2026-09-09 hardware: stock.py -- what to buy and how to cut it
    Cut list rows now carry the profile they are cut from, so pieces can be
    grouped by stock rather than guessed at from the label text. stock.py
    collects every part's list, groups by profile, and packs the pieces onto
    1 m and 2 m bars first-fit-decreasing.
    Saw kerf comes off every cut. Without it the plan looks fine and the last
    piece on each bar ends up 3 mm short.
    Current design: 4.26 m of 20x20 in 13 pieces, and 3.12 m of 20x40 in 4.
    Sheet rows are skipped -- a deck is not bar stock.
    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
2026-09-09 hardware: turn the enclosure 90 degrees, 500/300 rails
    Long rails now run along Y at 500 mm so they sit parallel to the machine's
    end, with 300 mm short rails between them along X. Those are cut lengths,
    so the outer footprint is 340 x 500 -- comfortably inside the 524 x 600
    bench zone, and it now reaches only to X +850.
    Contents re-laid out for the new 300 x 460 floor, 43% packed. Several
    blocks are turned to suit, so their width and depth are swapped in the
    table; signal stays on the machine-facing side, mains opposite.
    Height is still 200 mm. Twenty-millimetre uprights would give a 60 mm box
    and the Uno + shield is 45 mm before any wire above it, so that number is
    parked with a note rat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
2026-09-09 hardware: 200 mm enclosure uprights, box 240 tall
    Uprights were the last enclosure dimension still derived rather than
    given. Now all three -- 500 long, 300 short, 200 upright -- are cut
    lengths, and the 340 x 500 x 240 envelope falls out of them.
    Costs a bar: 200 mm uprights need 6 x 1 m of 20x20 (22% offcut) where
    160 mm fitted in 5 (9%), because a 500 + 300 pairing leaves 197 mm and a
    200 will not go in it.
    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
2026-09-15 tools: add soak.py, a timed endurance test for the servo reset
    The open problem in FINDINGS.md section 7 is "actuating the servo after a
    move resets the controller". Nothing in tools/ measures how long the machine
    survives that, which is the number needed to tell whether a hardware change
    actually helped.
    soak.py loops one cycle (Y move, pen down, Y move back, pen up), prints a live
    elapsed clock, and on death reports how long it lasted, how many cycles it
    completed, what command was in flight, and the last 20 lines the controller
    sent. Every run writes a timestamped log.
    Three arms isolate the variable: --mode both (the failure case), --mode motion
    and --mode servo (the controls FINDINGS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
    [soak.py]
2026-09-15 soak: add --axis, and stop asking GRBL for $$ twice
    --axis {X,Y} commands one axis and only that axis, so a cross-axis wiring
    fault (a Y command turning an X motor) can be cornered a motor at a time.
    Defaults to Y, which is what the previous version hard-coded.
    preflight() sent $$ once to print it and again to parse it. Send it once.
    Claude-Session: https://claude.ai/code/session_014EZ1xeWazPyXdvYcbVwqmZ
2026-09-16 tools: add servo_check.py - staged servo verification, parks pen up
    After a servo wiring change you want to know whether the supply holds before
    you thrash the mechanism, and you want the pen left lifted rather than limp.
    Neither existing tool does that: servo_sweep.py is interactive and parks
    wherever you left it, pentest.py starts from an already-energised servo and so
    never exercises the first-M3 case FINDINGS.md section 6 identifies as the
    largest current step.
    servo_check.py runs a ladder - energise at centre from limp, then swings at
    20%, 50% and 100% of the up/down range, then three full cycles - and stops at
    the first controller reset, naming the stage it reached. Where it dies is t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
    [servo_check.py]
2026-09-16 soak: lift the pen before travelling; add T14 as a plain G-code equivalent
    soak.py's cycle was move -> pen down -> move -> pen up, so the second leg of
    every cycle travelled with the pen on the paper. It scribbles, and it is not
    the motion a plot actually makes.
    Each leg now travels pen up, stops, then puts the pen down and lifts it again.
    That keeps the servo actuating immediately after a move - the failure FINDINGS
    section 7 describes - while never dragging the pen mid-travel, and it gives two
    actuations per cycle instead of one.
    T14_y_penlift.gcode is the same pattern as an ordinary test file for anyone who
    wants to read or stream it without the Python harness: ten cycles, G91 relative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
    [soak.py]
2026-09-16 soak: classify a timeout instead of just reporting one
    A command timing out with no boot banner is ambiguous three ways: the board
    hung, it reset and the banner was missed, or it is fine and an 'ok' was lost to
    serial desync. Those have different causes and the log could not tell them
    apart - a real run hit this and the evidence was a dead end.
    On timeout, poke the board with ? three times and say which case it is:
    silent (hung or dead), banner (it did reset), or a status line (alive, so the
    ok was lost). Verified against a stub for all three.
    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
    [soak.py]
2026-09-20 hardware: replace the extrusion enclosure with the UN4020 case
    The plan changed to a moulded polypropylene carry case, so parts/enclosure.py
    is deleted rather than left sitting around looking current.
    Case sits flat beside the machine at 352 x 413 x 206 outer, 277 x 400 x 198
    cavity, split 99 + 99. Contents divide the way the packing numbers want:
    PSUs, bucks, the three terminal buses and the IEC inlet on the floor at 43%
    packed; the control board and three TB6600s hanging from the lid ceiling at
    27%. Connectors sit in the lid top directly above the board, because putting
    them on the base would send every signal wire across the hinge instead of
    just the power pair.
    The TB6600s measure 96.5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
2026-09-20 hardware: lay the case lid out around a wiring lane
    The board is 125 x 85 with its ports on top, and mounted to the lid ceiling
    that means they face down into the bay. Laid out around that:
    - drivers hard against the hinge edge, so the heavy 24 V lands as soon as it
    crosses rather than running the length of the lid
    - board opposite, ports facing into a clear lane down the middle
    - all seven panel connectors drop into the lane, ordered so each sits beside
    what it wires to: USB and endstops at the board end, each stepper connector
    opposite its own driver
    Nothing now routes over a driver or across the board.
    The connectors are why the lane has to exist. A panel-mount GX16 hangs about
    2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
2026-09-20 hardware: drop the 5 V buck and bus from the case
    The Elecrow board regulates its own 5 V (500 mA) and 3.3 V (100 mA) from
    VMot, so an external 5 V rail fed nothing. Base drops from 43% to 37%
    packed, and the freed strip at x +50 becomes wire routing rather than
    another part to work around.
    The only conversion left in the case is 24 V -> 6.0 V for the servo, on its
    own supply for the reasons in FINDINGS.md section 7.
    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
2026-09-20 hardware: route the case harness and optimise the lid off the result
    Adds wiring.py, which models every bundle in the lid -- source, destination,
    conductor count, kind -- routes each as an L, and scores obstructions,
    crossings, noisy-alongside-signal, and length. Geometry comes from case.py so
    the analysis cannot drift from the model.
    The layout that looked clean by eye scored 20331 with two obstructions. The
    one in this commit scores 386 with none and uses a fifth less wire. The fix
    was not the connector order, which was already right -- it was the board,
    sitting at y -120 while the three drivers it talks to were at +25, +95 and
    +165. Moved to +60 it is beside them: the longest step/dir ru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
2026-09-20 hardware: draw the harness, and route the base as well as the lid
    The routed paths now come back into the model as 3D tubes, coloured by kind
    and sized by conductor count, so what you see is the harness that was
    scored rather than a drawing of one. 25 bundles, 67 conductors.
    Routing the base for the first time found it was in worse shape than the
    lid: 4 obstructions and 2 crossings, the worst being a 460 mm mains run
    from the IEC inlet diagonally across to the servo PSU, crossing both DC
    rails on the way. Mains are now clustered in one corner -- inlet and both
    PSU inputs together -- and 220 V stays out of the DC half.
    Two router faults that fixed the rest:
    - Ports faced the lid's lane no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
2026-09-20 hardware: split the viewer into a machine page and a case page
    The case had grown its own contents, fans, panel and harness, none of which
    mean anything at machine scale -- and the machine page was carrying all of
    it. Now there are two pages, and the case appears on the machine page as a
    black box with its port stubs, which is all it is from across the bench.
    The split is mostly about payload. Each page was loading the other's
    geometry: the deck mesh alone is 477 KB and says nothing about wiring, while
    the harness says nothing about gantry travel. The case page goes from 790 KB
    to 47 KB.
    web/_common.html now holds the CSS and the scene, orbit and theme plumbing,
    so machine.html and case.ht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
2026-09-20 hardware: give every bundle its own terminal, lane and selector
    The harness looked random for two concrete reasons, both now fixed.
    Components were points. Up to three bundles left from the exact centre of
    one edge and overlapped for their whole first leg. Each attachment now gets
    its own terminal, spread along whichever face points at its destination and
    ordered by where that destination lies, so bundles do not cross each other
    the moment they leave a part. Obstructions stay at zero, noisy-adjacent
    drops to zero, and total wire falls from 8819 to 7233 conductor-mm.
    Every bundle also ran at one of two heights -- one per bay -- so sixteen
    runs sat in the same plane and merged wherever their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
2026-09-20 hardware: distribution in both bays, mains splitter, and a BOM
    Closes the gap the router found: five lid loads -- three drivers, the board
    and the exhaust fan -- each started at the hinge with nothing to start from.
    Now one pair crosses the hinge and fans out from a DIN strip in each bay.
    The alternative was daisy-chaining driver to driver, which puts all 9 A for
    three drivers through the first one's screw terminal.
    A DIN strip stands ~58 mm on its rail, not the 30 mm a bare bus bar would
    be, so it is the tallest thing in the base now. Both bays have 99 mm.
    The lever splitter is modelled too -- it occupies floor and sits between the
    inlet and the two PSU inputs, so leaving it out would hav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
2026-09-20 hardware: model where the terminals actually are, and enforce it
    The port model was synthetic. The router took wires out of whichever face
    pointed at the destination, which quietly invented connections that cannot
    be made -- almost nothing in this case has terminals on more than one side.
    TERMINALS in case.py now records the faces each part's wires can leave from,
    with the confidence attached, because it varies: the TB6600 is measured off
    the drawing you sent, most of the rest is the part's obvious convention, and
    the Elecrow board is honestly marked UNKNOWN while its page stays blocked.
    Enforcing it caught a layout that was not buildable:
    - The three TB6600s were laid with their 96.5 mm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
2026-09-20 hardware: re-search the connector order against the real terminal faces
    Constraining wires to the faces they can actually leave from changed which
    connector order wins, so the search was re-run against it: 1036 to 884.
    Checked it does not buy that by stretching the lines that matter. The servo
    PWM halves, 144 to 70 mm -- it is single-ended and timing-critical and
    FINDINGS.md section 7 is a long argument about that servo being marginal.
    step_x1 drops 130 to 102. One motor phase grows 64 to 73, which is the
    trade, and phases are driver outputs rather than anything sensitive.
    Nothing is over its length budget. Obstructions stay at zero.
    C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
2026-09-21 hardware: split the electronics into two UN4412 boxes
    Replaces the single UN4020. Power box takes the IEC inlet, both PSUs, the
    servo buck, the mains splitter and the PSU-ground bond; control box takes
    the board, the three drivers and the distribution. Both run about 33%
    packed with spare panel positions left deliberately free.
    Three conductors between them, and the ground is two sizes up on purpose.
    The servo's 2.5 A return shares it, and at 0.75 mm^2 that lands ~94 mV on
    the logic reference every time the pen lifts -- which is the failure in
    FINDINGS.md section 7. At 2.5 mm^2 it is a quarter of that.
    Reverses the terminal-block recommendation. DIN blocks were right for a
    99 mm bay; in th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
2026-10-05 hardware: power box rail layout, with breakers and an E-stop relay
    Adds psu_layout.py: the rail schedule, the floor plan and the wire runs as
    tables, with both drawings generated from them, so the picture cannot
    disagree with the schedule printed beside it.
    193 mm of rail in a 402 mm wall, in four zones following the power: MCB1
    (6 A 1P+N) and the L/N/PE terminals; MCB2 (5 A DC) protecting the trunk
    wiring; K1; then DC distribution and four spare ways.
    K1 switches only the driver feed. The board sits upstream of it on
    +24 always, so an E-stop drops the motors while GRBL stays awake and can
    say so, rather than rebooting and losing its place. The button is
    normally-closed in series with the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
2026-10-05 hardware: route every conductor in the power box through a duct grid
    The rail layout showed nine bundles on one duct. The photo of the real
    parts says the gear cannot be placed that way: the LRS-350's terminals are
    on a 115 mm short end, so facing them at the back wall would need 215 mm of
    depth in a 265 mm floor. It has to lie long-ways with that face turned
    sideways -- which only works if there is something there to turn it toward.
    So the single duct becomes a grid: H1 across the face of the rail, and a
    vertical beside each piece of gear, placed so every terminal face points at
    one at 90 degrees. The RS-25 and the buck's IN terminals meet in V2; the
    buck's OUT terminals are on the opposit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
2026-10-05 hardware: control box layout, and a shared engine for both boxes
    The power box's router was 400 lines of logic wrapped around one box's
    tables. It is now panel.py, which knows nothing about either box, and the
    two layout modules are tables and prose.
    Two things the move exposed:
    - chain_for() assumed a single spine duct that every other duct touched.
    That held in the power box by luck. In the control box it sent six
    conductors straight through a stepper driver, because both ends happened
    to sit on horizontal runs and H1 was declared the spine. Duct adjacency
    is now computed from where the rectangles actually overlap, and the chain
    is the shortest path through that graph.
    - The cr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
2026-10-05 hardware: correct the TB6600 terminal face, and group the control box ports
    Two corrections from the user, both real.
    The driver was modelled with its two six-way blocks on opposite ends of the
    long axis, like the buck. That is wrong: all twelve terminals are on ONE
    long face, in two blocks side by side. The whole control box layout was
    built on the wrong premise -- drivers standing front-to-back with a duct at
    each end -- so it is rebuilt. The drivers now stand in a row with that face
    turned forward and one duct, H2, takes everything they have. STRIPS can
    carry an explicit offset list, because a face with two blocks and a gap
    between them is not a single pitch.
    The ports were placed by wh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
2026-10-06 hardware: DIN order list, and two corrections it turned up
    A page for ordering the rail parts, built the same way as the layouts: the
    specifications are written, the quantities are counted off the two rail
    schedules, so the order cannot drift from the drawings. Two figures carry
    the part nobody explains -- a block in section, and a comb bridging three
    of them -- because "how do I make a common bar" is not answerable in prose.
    Writing it turned up two things that were wrong in the design:
    - MCB2 was an AC miniature breaker on a DC rail. An MCB is tested on AC,
    where the arc self-extinguishes twice a cycle; on DC it does not. At 24 V
    that is survivable, but a 5 x 20 mm fuse terminal is c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
2026-10-06 hardware: supplier quote sheet for the DIN parts, and a ferrule colour fix
    din_bom.py is the same parts as din_parts.py addressed to whoever is
    quoting them: line references, full ratings against the standard each part
    is made to, quantities, and acceptable equivalents -- with none of the
    project reasoning, which is not their problem. Quantities still come from
    the two rail schedules, so the sheet cannot drift from the layouts. It also
    carries a plain-text version with a copy button, because a lot of this gets
    quoted over email and WhatsApp rather than from a web page.
    The ferrule colour table was wrong, and wrong in the way that costs you an
    order: it mixed two standards. 0.25 lilac and 1.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
2026-10-06 docs: bring HANDOFF up to date with the electronics design
    The handoff still described a repo where the 2040 frame was the only thing
    modelled. Section 8 now covers what the hardware work actually produced:
    the two enclosures, the 79 routed conductors, the DIN totals, the checks
    the layout engine enforces, and the six pages.
    The part worth reading is the last subsection, in the order it will bite:
    1. The Elecrow board's 5 V regulator has not been identified and 24 V into
    a linear one cooks it.
    2. Its header positions are guessed; the layout is drawn around a plausible
    strip and says so.
    3. The TB6600 block order within each face is the common one, not a
    verified one.
    4. The two ca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
2026-10-09 hardware: parametric wire-routing jig, straight and 90-degree bend
    N x 4 mm channels at 1.5 mm gap on a flanged stick-on base, matching the
    control-panel sketch. parts/wire_jig.py builds any channel count.
    Claude-Session: https://claude.ai/code/session_01JD3f81W4LbgDacav68rmoL
2026-10-09 hardware: wire jig straight module 20 -> 10 mm long
    Two short straights at 90 degrees replace the bend piece at corners.
    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
2026-10-09 hardware: flanged binding-post panels for the PSU-to-control power link
    Five posts per box (24 V, 12 V, 6 V, G1, G2). The PSU panel adds three
    rail switches, a 2-pole meter selector and a 0-30 V analog meter. Each
    plate overlaps a smaller box cutout, locates on a back boss and has
    Dymo-sized label pockets.
    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
2026-10-09 hardware: link panel as three voltage rows plus a ground column
    Each rail row is label, mini toggle, 2-wire voltage display and 4 mm
    jack; G1 and G2 sit in their own column. Builds with a 0.56" or 0.36"
    display and writes a true-scale mockup of both. Part sizes are typical
    until the purchased parts' specs are in.
    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
2026-10-09 hardware: link panel sized to the real 0.36in voltmeter, wider spacing
    Window for the 22.70 x 10.42 mm display block plus two M2 holes for the
    PCB ears (30.40 mm across). Parts spaced by what they occupy behind the
    panel plus 6 mm clear in a row and 8 mm between rows.
    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
2026-10-09 hardware: link panel in portrait, jack -> label -> display -> toggle
    Three voltage rows, a gap, then G1 and G2 under the jack column, to suit
    how the panel sits on the box. Plate corners rounded.
    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
2026-10-09 hardware: link panel screws 6 mm in from the edges
    Flange 8 -> 10 mm and corner radius matched to the screw centre, so each
    M3 hole has an even 4.3 mm wall to the plate edge.
    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
2026-10-09 hardware: link panel jack holes from the banana post datasheet
    12.2 mm hole for the M12 x 0.75 body (12 +/- 0.1 drill plus printed-hole
    allowance), 14.5 mm front cap, spacing set by an 18 mm rear nut.
    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
2026-10-09 hardware: countersink the link panel corner screws for M3 flat heads
    90 degree cone to 6.4 mm at the face for DIN 7991 / ISO 10642 M3 heads
    (6.0 mm), leaving 1.5 mm of straight 3.4 mm hole in the 3 mm rim.
    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
2026-10-09 hardware: link panel toggles from the KN3(A)-101 datasheet
    12.2 mm hole with its 1.9 x 0.9 mm anti-rotation key slot, spacing from
    the 28 x 16 mm body. TOGGLE_THROW picks the lever direction; horizontal
    keeps the plate on a 220 mm bed (vertical comes to 222 mm tall).
    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
2026-10-09 hardware: receiving link panel for the control box
    Same five jacks, same order and row pitch as the PSU panel, with label
    pockets, flange, boss and countersunk corner screws. Mockup now shows
    both panels side by side.
    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
2026-10-10 hardware: GX16 machine panel and lid layouts for both boxes
    Six GX16 sockets (three GX16-5 steppers, two GX16-3 endstops, a GX16-4
    pen servo) in two labelled rows on the same flanged plate. draw_lids()
    places every panel, the 80 mm fans and the IEC inlet on the 200 x 350 mm
    lid areas, and check_lids() flags anything off the lid or crowded.
    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
2026-10-10 hardware: lid layout for base-mounted electronics, two hinge crossings
    Receiving jacks move down the control box hinge edge; the top-right
    corner is kept clear for the motor bundle crossing; power and signal
    cross mid-hinge beside the jacks. Fan moves lower. Hinges and crossings
    drawn on the layout.
    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
2026-10-10 hardware: GX16 panel above the receiving jacks on the hinge edge
    All control box connectors in one column on the hinge side; the motor
    bundle drops straight from behind the GX16 stepper row into crossing 1.
    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
2026-10-10 hardware: printable 1:1 panel cutting templates and wire labels
    print_sheets.py writes panel_templates.pdf (one A4 page per panel:
    plate outline, cut line, M3 holes, machine end and hinge side marked,
    100 mm check ruler) and wire_labels.pdf (two of every wire label,
    grouped by where the wire runs).
    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
2026-10-10 hardware: full-colour wire labels, one row per wire, plus panel labels
    Each label is filled with its rail or axis colour, with black or white
    text chosen by WCAG contrast. One row per wire (both ends) so rows can
    be cut off during the build. New page of 13.4 x 9.4 mm labels for the
    panel label pockets, with spares.
    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
2026-10-10 docs: enclosure handoff, plus the PSU box layout and lid wiring sketches
    ENCLOSURE_HANDOFF.md records the plastic-box proof of concept, the part
    dimensions confirmed from datasheets, the power and grounding decisions,
    open flags, and the brief for the single 1 mm stainless enclosure that
    replaces the two boxes. The two sketch scripts move into hardware/sketches.
    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
2026-10-10 docs: enclosure handoff, observations behind the move to one stainless box
    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
2026-10-10 docs: DC wiring and protection, sized to the supply's current limit
    FINDINGS section 11 records the build-planning arithmetic: why the mains
    inlet fuse cannot protect the DC side (360 W fault = 1.8 A at the wall),
    so with no DC fuses each wire is sized to its supply's own current limit
    (1.5 mm² on 24 V and G1; 16 AWG is 1.31 mm² and falls short). Also the
    grounding rules for a non-isolated buck, cable and ferrule choices, and
    parts that look interchangeable and are not (CV vs CC LED drivers, lever
    splitters, terminal blocks that cannot clamp 0.25 mm²).
    Section 10's servo separation now reads 12 V supply -> buck, matching
    ENCLOSURE_HANDOFF. POWER.md is marked superseded on fuses and the s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
2026-10-10 docs: record the bench envelope the enclosure has to fit
    ENCLOSURE_HANDOFF names every internal constraint on the stainless box and
    no external one. The table is 1524 x 600 with the machine hard left taking
    1000 of it, so the clear area is 524 x 600 -- table.py computes it as
    free_zone() and nothing in the docs said so.
    Also notes, under the switch observations, that two UN4412 cases never fitted
    the bench flat in any arrangement: 910 mm side by side into a 524 mm gap,
    680 mm front to back into 600 mm of depth. Only stacking fitted, and stacking
    means the lower box cannot be opened. Not the reason for the switch -- the
    hinge problem was -- but a second one, and the envelope is inherited by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
2026-10-10 hardware: low-fi construction sketch for the stainless boxes
    Body and lid blanks with lips, corner tabs and bend reliefs, the lid's
    hole offset over the body's rivnuts, how a printed panel fixes into
    rivnuts set from inside, and the base plate on 5 mm standoffs. Writes
    hardware/out/enclosure_construction.svg. Schematic, for review before
    any cut files.
    Claude-Session: https://claude.ai/code/session_014yDbTWECCbjmRAeBb2Hkoy
2026-10-10 hardware: construction sketch - panels on screws and nuts, lid offset on the back too
    Panels fix with M3 countersunk screws and nyloc nuts (Ø3.4 holes), the
    printed 2 mm boss locating them in the cutout. Rivnuts stay for the lid
    fixings and the base plate. The lid hole offset over the body's rivnuts
    applies to the lid back as well as the top.
    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
2026-10-10 hardware: 3D enclosure inspector, and the lid fixing for outside-set rivnuts
    hardware/web/enclosure_inspector.html models both stacked boxes at size:
    lips, corner tabs, rivnuts, screws, washers, standoffs, base plates with
    the Ø6 grid, rubber feet, the printed panels and simplified parts inside.
    Explode, section cut, x-ray and click-to-identify for checking contacts.
    The rivnuts go in from outside, so their flange stands proud of the lip:
    the lid gets Ø9 clearance holes over each one and an M3 screw with a Ø12
    washer clamps it flat on the bare lip. Corner tabs fix with M3 screw +
    nut. Four rubber feet per box.
    Claude-Session: https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
2026-10-10 hardware: lid band, one lid fixing per lip, riveted corners
    Nothing mounts within 20 mm of the top or the back edge of a wall, where
    the lid's return lips land; the inspector checks every wall item against
    that band. The power box grows to 170 mm inside so the original PSU panel
    clears it; side panels sit as high as the band allows; the control box
    fan drops 8 mm and the earth stud moves forward.
    The lid fixes with one screw per lip: three on top (left, right, front)
    and three on the back (two back lips, base lip). The front corner tabs
    take two solid rivets each, set cold.
    Claude-Session: https://claude.ai/code/session_014yDbTWECCbjm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
2026-10-11 hardware: cut and bend pack for the two stainless boxes, v1
    hardware/sheet/enclosure.py builds the six flat patterns from one set of
    dimensions (control and power: body, lid, base plate) and writes them as
    DXF R12 in the SMPS drawings' layer convention: Visible (cut), Bend Center
    (CENTER2), Visible Narrow (bend-zone edges), Bend Notes, Leaders, Title.
    Every flat is drawn from the inside face; every bend is Up 90 R1.
    It refuses to write unless every check passes: holes >= 5 mm from bend
    lines and inside the outline, webs >= 1.5 mm, no folded clashes, lid
    clear of the body, each lid hole over its rivnut, base-plate standoffs
    over the floor's, panel cutouts and screw patterns equal to the prin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
2026-10-11 hardware: USB-C and antenna move onto a small printed panel
    A 50 x 20 cutout with four M3 holes on the control box's left wall takes a
    70 x 40 printed panel carrying the USB-C adapter and the SMA antenna, so
    either part can change without new steel. Generator and inspector updated;
    628 checks pass. Not yet re-issued as a cut pack: waiting on the rivet and
    fan measurements.
    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
2026-10-11 hardware: cut pack v2 - USB/antenna panel; rivets, fan and M3 rivnut confirmed
    Same checks as v1 (628 pass, refold exact, ezdxf audit clean). Changes from
    v1: the USB-C and antenna holes become one 50 x 20 panel cutout with four
    M3 holes. Rivet holes (Ø3.2), fan pattern (71.5 square) and M3 rivnut
    holes (Ø5) confirmed by measurement.
    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
2026-10-11 Add whole-assembly clearance check (finds fan/base plate clash)
    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
2026-10-11 Enclosure v3: fold tolerances, assembly gate, base plate notches
    - Folded flanges that must not touch keep 2.5 mm (rule >= 2): side back lips,
    base back lip, front top lip, lid side returns
    - Lid clearance 0.5 -> 1.0 mm per side; lid holes 9 -> 10 mm
    - Side walls and corner tabs stop 0.5 mm shy of the front wall
    - Base plate notched clear of the control fan and the base back rivnut;
    power fan raised 5 mm
    - assembly_check now covers steel gaps and reads panels, fans and rivnuts
    from the generator; enclosure.py refuses to write cut files on any clash
    - Inspector values written by the generator (GEN block)
    - Cut pack v3; v2 marked superseded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
2026-10-11 Corner mark studies: black print only, small corner emblems
    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
2026-10-11 Power front: hex vent field easing out from the top-left corner; cut pack v4
    80 hex holes (2.6-6.8 mm across flats, 9 mm pitch) inside the outline
    from Allwin's sketch. New poly hole kind in the DXF writer; inspector
    draws the same holes from the generator.
    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
2026-10-11 Revert hex vent field on the power front (cut pack v4)
    Back to the v3 design; v3 cut pack is current again.
    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
2026-10-11 Lid fixings: M3 x 16 mm penny washers over the 10 mm lid holes (rivnut flange measured 8 mm)
    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
2026-10-11 Stacking: printed locating feet under the control box, peg holes in the power lid
    Flange 24 x 6 mm spaces the boxes and clears the lid fixings and floor screw
    heads; Ø7.6 peg drops into the power lid: Ø8 front-left locates, 8 x 11 slot
    front-right stops rotation, Ø10 at the back only clears. New stack checks and
    assembly items; inspector reads the same numbers. No cut pack issued yet.
    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
2026-10-11 Inspector: wall cutouts and printed panels come from the cut files
    GX16 rail shows as its 192 x 47 cutout with the printed rail (3 mm plate,
    2 mm boss) like every other panel; USB/antenna panel at its real height;
    panel screw holes drawn. Steel unchanged apart from the foot hole note.
    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
2026-10-11 Power front art: brush strokes + ETCH mark (Orbitron Black) replace the stepped vents
    strokes.py holds the hand-drawn design: 7 short strokes with a brush width
    profile and a height profile (flush tips, up to ~5 mm proud), and the ETCH
    mark outlines (mark_etch.json, built from Orbitron Black, SIL OFL). The
    generator cuts them as slots, checks flange spacing and the mark's clearance,
    and the inspector draws the printed ribs and embossed mark from the same data.
    No cut pack issued yet.
    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
2026-10-11 Power front: stepped vents back, brush strokes removed, ETCH mark kept
    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
2026-10-11 Docs: enclosure state of the world, renderer how-to, learnings
    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
2026-10-11 Line up the stacked boxes: fans in one column, jack panels in one column
    Both fans at z = D/2 - 68 (clear of the front base-plate standoffs), USB panel
    moved to the old control-fan spot, IEC panel back 12.5 mm. Receiving and PSU
    panels share one centre so each rail's jack sits over its partner. New checks:
    fan and jack alignment, and 3 mm between panels/fans/stud outside each wall.
    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
2026-10-12 Enclosure: remove ETCH mark from power front; plain panel with vents for cut prep
    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
2026-10-12 Enclosure: full-width power vents; fix mirrored body flats; fold-from-DXF check; bend relief check
    - Power front vents: 3 rows x 12, centred, full width.
    - Body flats mirrored left-right so 'drawn from inside, bends UP' folds to the design
    (previous body DXFs folded as a mirror image; lids were correct).
    - fold.py: folds the DXFs with real bends, checks holes, sizes, self and assembly
    collisions, and lid/tab fit for shop radii R0.6-R2.5; exports glb/STL for Blender.
    - New check: every bend end is relieved; base front corner reliefs extended.
    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
2026-10-12 Enclosure: Ø5 accessory holes (control lid corners, power front 3+2); centre GX16 rail
    Plain Ø5 holes take an M3 rivnut (set later from outside) or a printed plug.
    Assembly check models a 10 mm rivnut body behind each; nearest part 13 mm.
    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
2026-10-12 Enclosure: power-front split acrylic windows; vent rows 145/136/42; drop top accessory row
    Two windows split by a slanted bar (330 span, 40 tall, 40 deg, R3, 20 mm steel between
    9 mm bezels), 4 M3 bezel screws each. Inspector draws the acrylic and bezels.
    fold.py: lid-on-body contact no longer reads as overlap (thickness test; 0.3 mm push fails).
    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
2026-10-12 Enclosure: control lid top window (330 x 40, R3), bezel + acrylic, 6 M3 screws
    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
2026-10-12 Enclosure: control front GX openings per group (6 mm play) with M3 rivnuts; printed plates in inspector
    Replaces the 192 x 47 GX rail cutout. Sockets mount in printed plates; steel only has
    plain openings so the socket layout can change with a reprint.
    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
2026-10-12 Enclosure: control front trapezium window (96 x 30, left end 40 deg), bezel + acrylic
    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
2026-10-12 Enclosure: control front window 40 tall; remove the control lid window
    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
2026-10-12 Enclosure state: park window status lighting and the print parts for later
    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
2026-10-12 Enclosure: USB panel cutout 80 x 30 (plate 100 x 50) for the pendant GX16; log pendant open questions
    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
2026-10-12 Enclosure state: note spare 6x capabilities for later ports
    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
2026-10-12 duct_check.py: cable-duct clearance on the base plates (rings + bridges vs walls, panels, GX, parts)
    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
2026-10-12 Cut pack v4: 6 steel/Al parts + 3 window acrylic, cover sheet; v3 superseded
    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
2026-10-12 Inspector: Steel only toggle (shows just the laser-cut 304 parts)
    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
2026-10-12 Enclosure state: v4 sent; base plates 1 mm SS or 2 mm MS; next the printed parts
    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
2026-10-13 Enclosure state: mains panel parts (3-in-1 IEC, 2 LEDs, LA38 stop)
    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
2026-10-13 Fit kit: 23 test prints for the printed parts (screws, inserts, GX16, IEC, LED/stop, bezel, pegs, plugs, LED strip, cable holders)
    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
2026-10-13 Window inserts (WIP): nut frame, contour relief, acrylic bezel, card frame, pen garage
    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
2026-10-13 Inspector: swappable window inserts (open / acrylic / relief / card / pens) from the printed parts
    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
2026-10-13 Window inserts: slotted pen rack replaces the pen garage (marker slot + regular slots at the window slant); demo pens in the inspector (WIP)
    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
2026-10-13 Fit kit: coupon I, bolted bezel strip + snap-on panel latches (barb 0.6/0.8/1.0)
    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
2026-10-13 Window inserts: rack_layout takes any outline + slot list (for snap-on panels)
    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
2026-10-13 Window panels: bolted bezel strips + snap-on panels (relief, acrylic, rectangular card and pen garage); inspector updated
    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
2026-10-13 Window panels: switch to magnets (bolted 11 x 2.5 bezel, 4 x Ø6x1.5 magnets, 2.6 mm panels); fit-kit coupon I = magnet pockets (WIP, not built yet)
    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
2026-10-14 Cut pack v5: three identical 143 x 50 R5 windows on M3 rivnuts, logo keyhole slot, middle top vent row dropped, IEC/USB panels on rivnuts; magnetic window bezels and panels rebuilt; inspector updated
    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
2026-10-14 Window panels: acrylic and card become one inlay panel (3 mm pocket: acrylic, or card on a printed backer); card on every window
    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
2026-10-14 Window panels: pen garage replaced by a simple pen cup; logo spine and logo plate modelled and shown in the inspector
    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
2026-10-14 Cut pack v5: add ALL_STEEL_PARTS.dxf and ALL_ACRYLIC_PARTS.dxf (every part in one drawing, labelled) for the fabricator
    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
2026-10-14 Cut pack v5: four combined drawings (ALL_SS304, ALL_MS, ALL_ACRYLIC, ALL_PARTS); base plates in 2 mm mild steel (title text only)
    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
2026-10-14 Enclosure state: park interior lights and fan/light switches
    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
2026-10-14 Enclosure state: v5 sent to the vendor; park the DIN-rail power box idea
    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
2026-10-15 Cut pack v5: DXF 2004 copies of every file (vendor's CAD can't read R12), checked entity by entity against the R12 originals
    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
2026-10-15 Enclosure state: vendor started cutting v5 (DXF 2004)
    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
2026-10-15 Window acrylic v1 (separate vendor): screwed into the window rivnuts, 169 x 76 with 4 holes, one DXF 2004; thin snap bezel; inspector option 'Acrylic, screwed'
    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
2026-10-15 Inspector: merge the filament-colour preview from the live page with the screwed-acrylic option
    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
2026-10-16 Control box DIN rail lofi (board + 3 TB6600 on printed clips)
    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
2026-10-16 DIN lofi v2: flat TB6600 on L-clips, two-duct wiring split
    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
2026-10-16 DIN lofi v3: board rotated 180 at the USB-panel end
    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
2026-10-16 DIN lofi: back to v2 layout (board upright, right end), add noise note
    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
2026-10-16 DIN adapter plates: TB6600 L-plate and board H-plate on bought DIN clips
    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
2026-10-16 DIN plates: heat-set insert pads for the clip screws, organic frames
    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
2026-10-16 DIN plates: bores for M3x4 OD4.3 inserts, 1:1 DXF export
    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
2026-10-16 Room walls lofi: wall D agreed, add current and proposed top views
    Claude-Session: https://claude.ai/code/session_011WaRreZyvZeqXo6J7Pr3nx
2026-10-16 Sheet: back lips and corner tabs end 2.0 under the top lip for any thickness; fold check tolerates rounded bend lines
    Both are no-ops at 1.0 mm (v5 output byte-identical); needed for a 1.2 mm run.
    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
2026-10-16 Cut pack v6: stainless in 1.2 mm 304 (R1.2, BD 2.086), steel-only folder + DXF 2004; MS plates unchanged
    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
2026-10-16 Room plan: split rack (A on folding table, B in A3), wire reels, A3 drawing
    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
2026-10-16 Room plan: wire on flat cards in SAMLA, no reels; rack B holds boxes
    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
2026-10-17 Add ply cut sheet for the bench backboard (R05)
    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
2026-10-17 Inspector: draw the lid-fixing rivnut hole in every body lip (they were solid bars); sheet thickness from GEN (1.2)
    Cut files unchanged (v6 DXFs byte-identical).
    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
2026-10-17 Lofi: GX plate options (flat, wedge, sawtooth, sideways)
    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
2026-10-18 GX plates: plain GX16 holes on the new panel rules (countersunk M3, rivnut flange relief, 2 mm locating lip); plates +2 on rivnut sides
    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
2026-10-18 GX plates: rounded corners (R7 steppers, R5 servo/endstops)
    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
2026-10-18 Bench power lofi: 6 A strip, lab supply, fused 12 V, USB-C PD
    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
2026-10-18 Harbor labels: 60x12 mm colour-coded bin labels, printed twice
    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
2026-10-18 Harbor labels: colour the screw size (resistor code), icons for nuts, washers, rivets
    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
2026-10-18 Wire bend jig: spinning sleeves (Ø16/24/40) over M3 posts on a Meccano plate
    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
2026-10-20 DIN grip: printed slide-on TS35 grip profile + fit coupons (0.1/0.2/0.3 clearance)
    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
2026-10-20 DIN grip: 3D viewer of the test coupon on rail
    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
2026-10-20 DIN grip: loose 0.3 grip + anchor tab (M3 jack screw into a brass insert)
    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
2026-10-20 DIN plates: TB6600 flange holes 89 apart (+-1 slots), board bosses take M3x4 inserts (test print 2026-10-20)
    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
2026-10-20 Control box layout check: 3 TB6600 + board on one rail vs keep-outs
    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
2026-10-21 Layout check: two 8-inch rails (A full under the drivers, B cut to 120 under the board), clips and rail screws
    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
2026-10-21 Board on an uncut 8-inch rail turned front-back: board plate clips rotated 90 deg; layout updated
    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
2026-10-21 Bench board lofi: landscape and portrait layouts for the painted backboard
    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
2026-10-21 Bench board: portrait standing on the floor, hidden power zone behind the bench
    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
2026-10-21 Bench board: bins low on hook-lip rails, SKÅDIS above, reach lines for 163 cm
    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
2026-10-21 Bench board: low shelf 17 cm over the bench, light shelf on brackets, bins and SKÅDIS shifted up
    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
2026-10-21 Inspector: Meccano window panels (or open); magnet/acrylic/card/relief/pen-cup window designs retired; bundle 4.7 -> 1.8 MB
    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
2026-10-22 Build book: IKEA-style 2D pages from the generator (lofi: earth stud, base plate, IEC panel)
    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
2026-10-22 Build book: all steps as IKEA-style pages (faces from the generator, parts traced from STLs), BOM and Prints at the back
    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
2026-10-23 Bench lofi v2: A3 axis on the old 1000x560 base frame, cabinets inside it
    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
2026-10-23 Bench lofi v3: base frame kept, 560 divider, 600 rails on plates over the 1000s, 700 bar as today
    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
2026-10-23 Bench lofi: P0 keeps the bar on the 1000s with stop blocks at 600; raised rails parked
    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
2026-10-23 Build book 1.1: M6 x 30 earth bolt (x 20 too short for the stack); statuses for 0.1-0.3 set to Have
    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
2026-10-23 BOM: light DC wire needs black only (red 1.0 mm² in stock)
    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
2026-10-23 Build book 1.2: plates are the 2 mm mild steel already cut; standoffs stay 5 mm (6+ clashes)
    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
2026-10-23 Build book 1.2/2.1: 8 mm M-F standoffs, M4 x 6 Phillips pan from below, nut on top; control plate notch for the window rivnut
    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
2026-10-23 Gantry workstream: state file, folder for acrylic STLs and the gantry inspector
    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
2026-10-23 Gantry lofi v1: ACRO acrylic plates on the frame and 700 bar
    acro_plates.py splits Allwin's ACRO STL into its 11 parts and traces outlines
    and holes; gantry_lofi.py draws the parts, a section across the rail and the
    bay top view from that plus params.py. The STL stays git-ignored until its
    licence is checked (public repo).
    Claude-Session: https://claude.ai/code/session_01EdzQA5WiRVtykbZRZaHfvz
2026-10-23 Gantry lofi v2: gantry plates stand upright outside the rails
    Allwin's correction: the ACRO gantry plates stand on the rails' outer faces,
    not flat on top. The file agrees (59.25 wheel holes = a standing 2040; the
    bar's end bolts to the plate). The section now shows the rail lifted for the
    bottom wheels, the bar end-bolted (~602 of 2040), the motor outboard; reach
    comes from the head, not the plates.
    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
2026-10-24 Build book: print-ready A4 PDF v1 (43 pages) and the script that makes it
    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
2026-10-24 Side tower lofi: slotted-angle rack boxed in ply at the bench end
    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
2026-10-24 Side tower: board horizontal on a French cleat, tower in front of its right end; mark vertical board page out of date
    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
2026-10-25 Printer tower lofi: one open 12 mm carcass, A1 above a storage bay, 7x4 cut
    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
2026-10-27 Harbor: 15 s vertical reel of the room coming together
    harbor_reel.html animates the room build (walls, furniture, board, bins,
    planned items) on a fixed timeline; render_reel.js records it frame by
    frame with Playwright and encodes a 1080x1920 MP4 with ffmpeg.
    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
2026-10-27 Harbor: UTESPELARE desk and LINNMON bench in Now; reel v2
    The black table at the window corner is the UTESPELARE laptop and
    monitor desk along the window wall, not a trestle table. LINNMON sits
    under the board (position to confirm). The reel drops the sawhorses and
    the light-stand pole, and shows the 2 x 2 ft printer tower and the
    island as next.
    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
2026-10-27 Add R06 Beacon wall plate and tip hanger (WiZ batten arm)
    Beacon has no repo of its own; its Handoff puts printed parts here.
    Wall plate: pinned-truss pivots for the lifted single arm, slotted
    lower pivot to close the triangle and level the batten. Tip hanger:
    Allwin's U that hangs plumb from one rod through the rails' 41 cm
    holes, crossbar bolted under its base.
    Claude-Session: https://claude.ai/code/session_01ES3S6qzPamWhuMmyfPuay5
2026-10-27 Beacon parts v2: 10 mm ears with M4 nut pockets, two-bolt tip pivot
    Allwin wants nuts to nestle into the print and short bolts at the tip
    instead of one rod through both rails. Ears and tabs go to 10 mm to
    carry a 3.4 mm hex pocket; all pivots become M4 x 20.
    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
2026-10-27 Harbor Now: printer tower in progress (photo 2026-10-27)
    Slotted-angle rack with a ply shelf, top and one side, in front of the
    board's right end. Plans: printer box marked Building, side tower merged
    into it.
    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
2026-10-27 Beacon tip hanger v3: organic profile from a topology run
    A 2D SIMP run showed the batten load goes straight up the legs; the
    slab between the crossbar bolts only resists sideways knocks. v3 keeps
    curved legs and an arched tie (6 mm floor), prints on its side so the
    profile needs no support, and halves v2's volume. fe_check.py confirms
    peak stress about 0.06 MPa under the 400 g batten.
    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
2026-10-27 Beacon wall plate v3: organic frame from a coarse 3D topology run
    The run kept a top band (ties into the top screw), pads behind the
    lower ears, two legs and a bar to the lower screw; the rest of v2's
    back plate carried almost nothing. v3 opens a window and a bottom
    notch: 104 cm3 vs 162. Strength checked by hand (~1 MPa in the band);
    the full 3D stress solve was dropped as more compute than the loads
    justify.
    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
2026-10-27 Beacon v4: compact arm without dowels, three-screw wall plate
    Allwin drops the dowel rungs: the beam becomes two strips with two M4
    nuts as spacers, ties outside it. Wall plate v4 has a fin in the beam
    gap and a block between the ties, a 6 mm face, and three screws (two
    beside the upper pivot, one below the lower fin). Tip hanger v4 is one
    fin in the gap with curved arms to the crossbar bosses. Every pivot is
    clamped between strips; hand checks put peak stress near 0.6 MPa.
    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
2026-10-27 Beacon wall plate v4: raised bosses for countersunk drywall screws
    Allwin is using CSK drywall screws in plugs. Each screw gets an 8 mm
    boss so the 9 mm countersink leaves a 3.5 mm straight clearance hole
    under it (no threads in the print); fits #6 and #8 bugle heads.
    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
2026-10-27 Beacon Plans artifact source (3D arm views and part inspectors)
    The room's Plans page embeds the part STLs; keeping its source next to
    the parts so it can be republished from the repo.
    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
2026-10-27 Prints: rest pads dropped (mild steel plates kept)
    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
2026-10-28 Prints: board plate, GX plates, Meccano windows printed; bend-jig sleeves dropped
    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
2026-10-28 Harbor Now: sync the Beacon light arm that R06 published to the live artifact
    R06 Beacon edited Harbor Now directly; its source was not in the repo.
    room_now.html and room3d.html now match the live artifact (version
    1793146354-63cc).
    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
2026-10-30 Beacon bridge: C that ties the doubled arms together
    Allwin doubled the arm (2026-10-30), 200 mm apart as set by the tip
    hangers sharing one 32 cm strip. Two printed Cs go on the beams' 11 and
    21 cm holes: each lip replaces the two spacer nuts in a beam gap and
    the back runs across under the beams.
    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
2026-10-30 Beacon gap block: cheap bridge with a wood strip
    Allwin wants less plastic: print only the part that sits in a beam gap
    and bolt a spare 32 cm strip across underneath (its holes 1 and 21 are
    200 mm apart, the arm pitch). Four blocks, two strips; the C bridge
    stays in the folder as the alternative.
    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
2026-10-30 Beacon batten clip: rigid two-part clamp instead of the T5 spring clips
    Allwin isn't happy with how the stock clips hold the batten. PLA can't
    spring like the steel clip, so the base screws to the crossbar with a
    fixed tooth and a sliding jaw locks the other side with an M4 x 12.
    Rail profile copied from the stock clip; test-fit one pair first.
    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
2026-10-31 Fume extractor v1: six stacked layers around an 80 mm fan, viewer page
    Flush screwless face on a lip and magnets; M3 CSK into heat-set inserts in the fan
    layer from behind the face and from the back; hollow walls and ribbed grille plates
    (about 240 g PETG). Handle, pad, jack and switch sizes are assumed until measured.
    Claude-Session: https://claude.ai/code/session_01Rgk9R48KJ4irUyHWKfYHLp
2026-10-31 Fume extractor v2: stack screws through the fan's corner holes, body 90 x 125
    All ten heat-set inserts move to the spacer (L4); 6 x M3 x 45 from the back, 4 x M3 x 16
    under the face; the face magnets pull on the front screw heads; pads 80 square with
    16 mm corners snipped. Viewer shows the screws.
    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
2026-10-31 Fume extractor: drop the cabinet pull; 2 x M4 inserts on top for a 5-hole Meccano strip
    The pull's holes are 85 apart, too wide for the 90 body. Inserts 50.8 apart (Meccano
    end holes, three between); body 3.7 taller so the top wall takes the insert.
    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
2026-10-31 Fume extractor v2 viewer: 90 x 129 x 70, screws and Meccano handle shown
    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
2026-10-31 Fume extractor v3: one screw set into inserts in a merged back part
    Six M3 x 60 from the front of L5 through L4 and the fan into blind heat-set inserts in
    the back part (rear pad pocket + grille in one print). Magnets sit on the four fan-screw
    heads in L5 and snap to four in the face. Five prints.
    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
2026-10-31 Fume extractor v3 viewer: five prints, one screw set, magnets on the screw heads
    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
2026-10-31 Fume extractor v4: three prints, M3 x 50 only
    Spacer gone; jack and switch in the body's chin; fan, rear pad and grille in one body.
    Front filter gains a 3.5 mm rib grid plenum. Inserts sit where 50 mm screws reach:
    four on bosses under the fan corners, two at the chin face. Depth 57 mm.
    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
2026-10-31 Fume extractor v4 viewer: three prints, M3 x 50
    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
2026-10-31 Fume extractor v5: M3 inserts only (4 mm long), Ø12 jack beside the switch
    Handle inserts are M3 (Meccano holes pass M3), so the top wall and body shrink 2.5 mm.
    Pad pocket stays 10 for the 9 mm pad. Fan confirmed 12 V.
    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
2026-10-31 Fume extractor: checks-only by default (--stl to export); grille options page
    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
2026-10-31 Fume extractor: plain Ø74 openings, grilles as swappable inserts
    Face and back panel get one hole each; a grille insert (pocket-shaped plate + boss flush
    with the outside) sits behind it, pinned by the pad. Patterns: hslots (default, with a
    hidden spine), rings, hex, holes; --grilles=a,b picks which to export.
    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
2026-10-31 Fume extractor v5 viewer: grille inserts shown; full build now about 1 min
    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
2026-10-31 Fume extractor v6: base with corner tabs, chin tabs and spacers; no stray voids
    The rear pad sits between solid corner tabs that stop at the top of the pad; the fan
    sits on the tab tops (inserts there), with only the outer wall round it. Two chin tabs
    and two printed spacer tubes replace the deep chin bosses. Pad layers are solid round
    the pad, which removes the small voids beside each boss.
    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
2026-10-31 Fume extractor v7: jack and switch in the back panel, 2 x M5 inserts per side
    Back-panel holes print round; the 15 mm switch body sits in the chin. Each side gets
    two M5 heat-set inserts in a solid block that runs back to the panel (no supports).
    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
2026-10-31 Fume extractor v8: full-height chin tabs (no spacers), 3 magnets in the chin
    Chin tabs run the full height of the base with their inserts in its front face. The face
    holds by its lip plus 3 magnet pairs (bottom centre, one low on each side). All six
    screw heads sit flush; no magnet seats on the screws.
    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
2026-10-31 Fume extractor v9: chin tabs clipped to the outline, round magnet bosses
    v8's chin tabs were rectangles that poked out of the rounded corners; they are now
    smaller corner blocks clipped to the outline, with a check that no block leaves it.
    Viewer: black body, orange grilles, decorative handle on 5 mm standoffs.
    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
2026-10-31 Fume extractor: Ø6 x 1.5 magnets from stock, enclosure pocket size
    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
2026-10-31 Fume extractor: collision check script; print STLs sit on the bed
    collide.py assembles the three prints with stand-ins for the fan, pads, screws, inserts,
    magnets, jack, switch and standoffs and reports every overlap: none (only faces touching).
    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
2026-10-31 Fume extractor viewer: prints are PLA
    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
2026-10-31 Fume grilles print octagon plate down (no overhang)
    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
2026-11-01 Fume extractor reel v1: 15 s assembly with captions, hold, constant-rate orbit
    Meshes packed from the fume model; textured PLA grain, cutting-mat floor; hero framed
    like Allwin's photo; orbit 15 deg/s for the turntable jump cut.
    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
2026-11-03 Cedar CAD run 1: tower bench supply, end plates, deck, inspector
    R09 Cedar (bench power supply). Two printed end plates and a deck hold an
    ATX PSU on its side with six DIN rails (3 front, 2 rear, 1 base). Rail tabs
    use nut channels so any cut rail's slots land on a screw. Inspector page
    with explode, section and checks; no STL downloads yet. KV121, HY-Z09,
    rail slots and PSU screw holes are placeholders.
    Claude-Session: https://claude.ai/code/session_01Rgk9R6oVnayFiXS2axFtr1
2026-11-03 Cedar CAD run 2: sloped plates, rail seats, sleeve with end wall, wood base
    From lo-fi v7 (Allwin): side profile with a 64 deg slope and R22 corner;
    5 rails (top terminals + DIN switch, 2 back, 2 slope) in one standard seat
    (surface + clamp, screws outside the rail); PSU on 4 wood strips through
    both plates; a profile-following sleeve over the cable bay with ribs that
    the rails screw into, and a flat end wall carrying the ATX board on bars,
    leaving the PSU face open for its cables. 19 checks pass.
    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
2026-11-03 Cedar CAD run 3: wood back, slats on the sleeve, handles, drop-in nuts, interlocks
    From lo-fi v10 (Allwin): 3 DIN rails; 6 wood slats in their own slots,
    each screwed to the sleeve; drop-in nuts in the rail seats; handle slot
    on the top rail; 209 deep; PSU pocket, end-wall collar and keys, groove
    for the sleeve. 21 checks pass.
    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
2026-11-09 Etch frame lo-fi v3: ACRO layout on 1000 rails over 560 ends, PETG end plates with snap-on feet
    Merges the gantry acrylic branch. Gantry plate geometry is traced from the ACRO STL
    (acrylic/acro_traced.json, git-ignored). Published to the Etch Gantry Lofi page.
    Claude-Session: https://claude.ai/code/session_01Rgk9R5i7JwVyZASfcwb3AG
2026-11-09 Etch frame lo-fi v4: rails lifted 28 above the 560s, 700 bar through PETG X plates, corner-cap feet
    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
2026-11-09 Etch frame CAD run 1: L-brackets on the 1000 rails' inner faces, corner feet, 6 mm PETG X plates with a window for the 700 bar
    All checks pass (no clashes over 27 parts, bed fit, wheels 6.2 over the 560s,
    left limit at x 47). Inspector published as Etch Frame Inspector.
    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
2026-11-09 Etch frame CAD run 2: 1000s rest on the 560s, flat end brackets on the outer faces, small corner grabs
    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
2026-11-09 Etch frame CAD run 3: wrap-round end brackets (9 M5, 45° gusset to the 560), separate corner grabs, print layout row
    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
2026-11-09 Etch frame CAD run 4: one flat end plate per corner on the outer face (column + arm + 45° chamfer); corner grab back to a placeholder
    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
2026-11-09 Etch frame CAD run 5: end plate column keys 5 mm into a closed pocket in the foot
    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
2026-11-09 Etch frame: --print writes the flat print STLs (end plate x4, corner grab A/B x2, X plate x2)
    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
2026-11-09 Etch frame: key/pocket fit tester (0.1/0.2/0.3 clearance) in --print
    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
2026-11-09 GANTRY_STATE: current frame (CAD run 5) on top; older plans kept below
    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
2026-11-10 Etch frame CAD run 6: end plate without key, flush with the 560; 2020 risers replace the corner grabs
    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
